UniSA-Motorsport-Test1/2024-power-and-monitoring-board/power_and_monotoring/Power_and_montoteringPDF/power_and_monotoring-logic.pdf

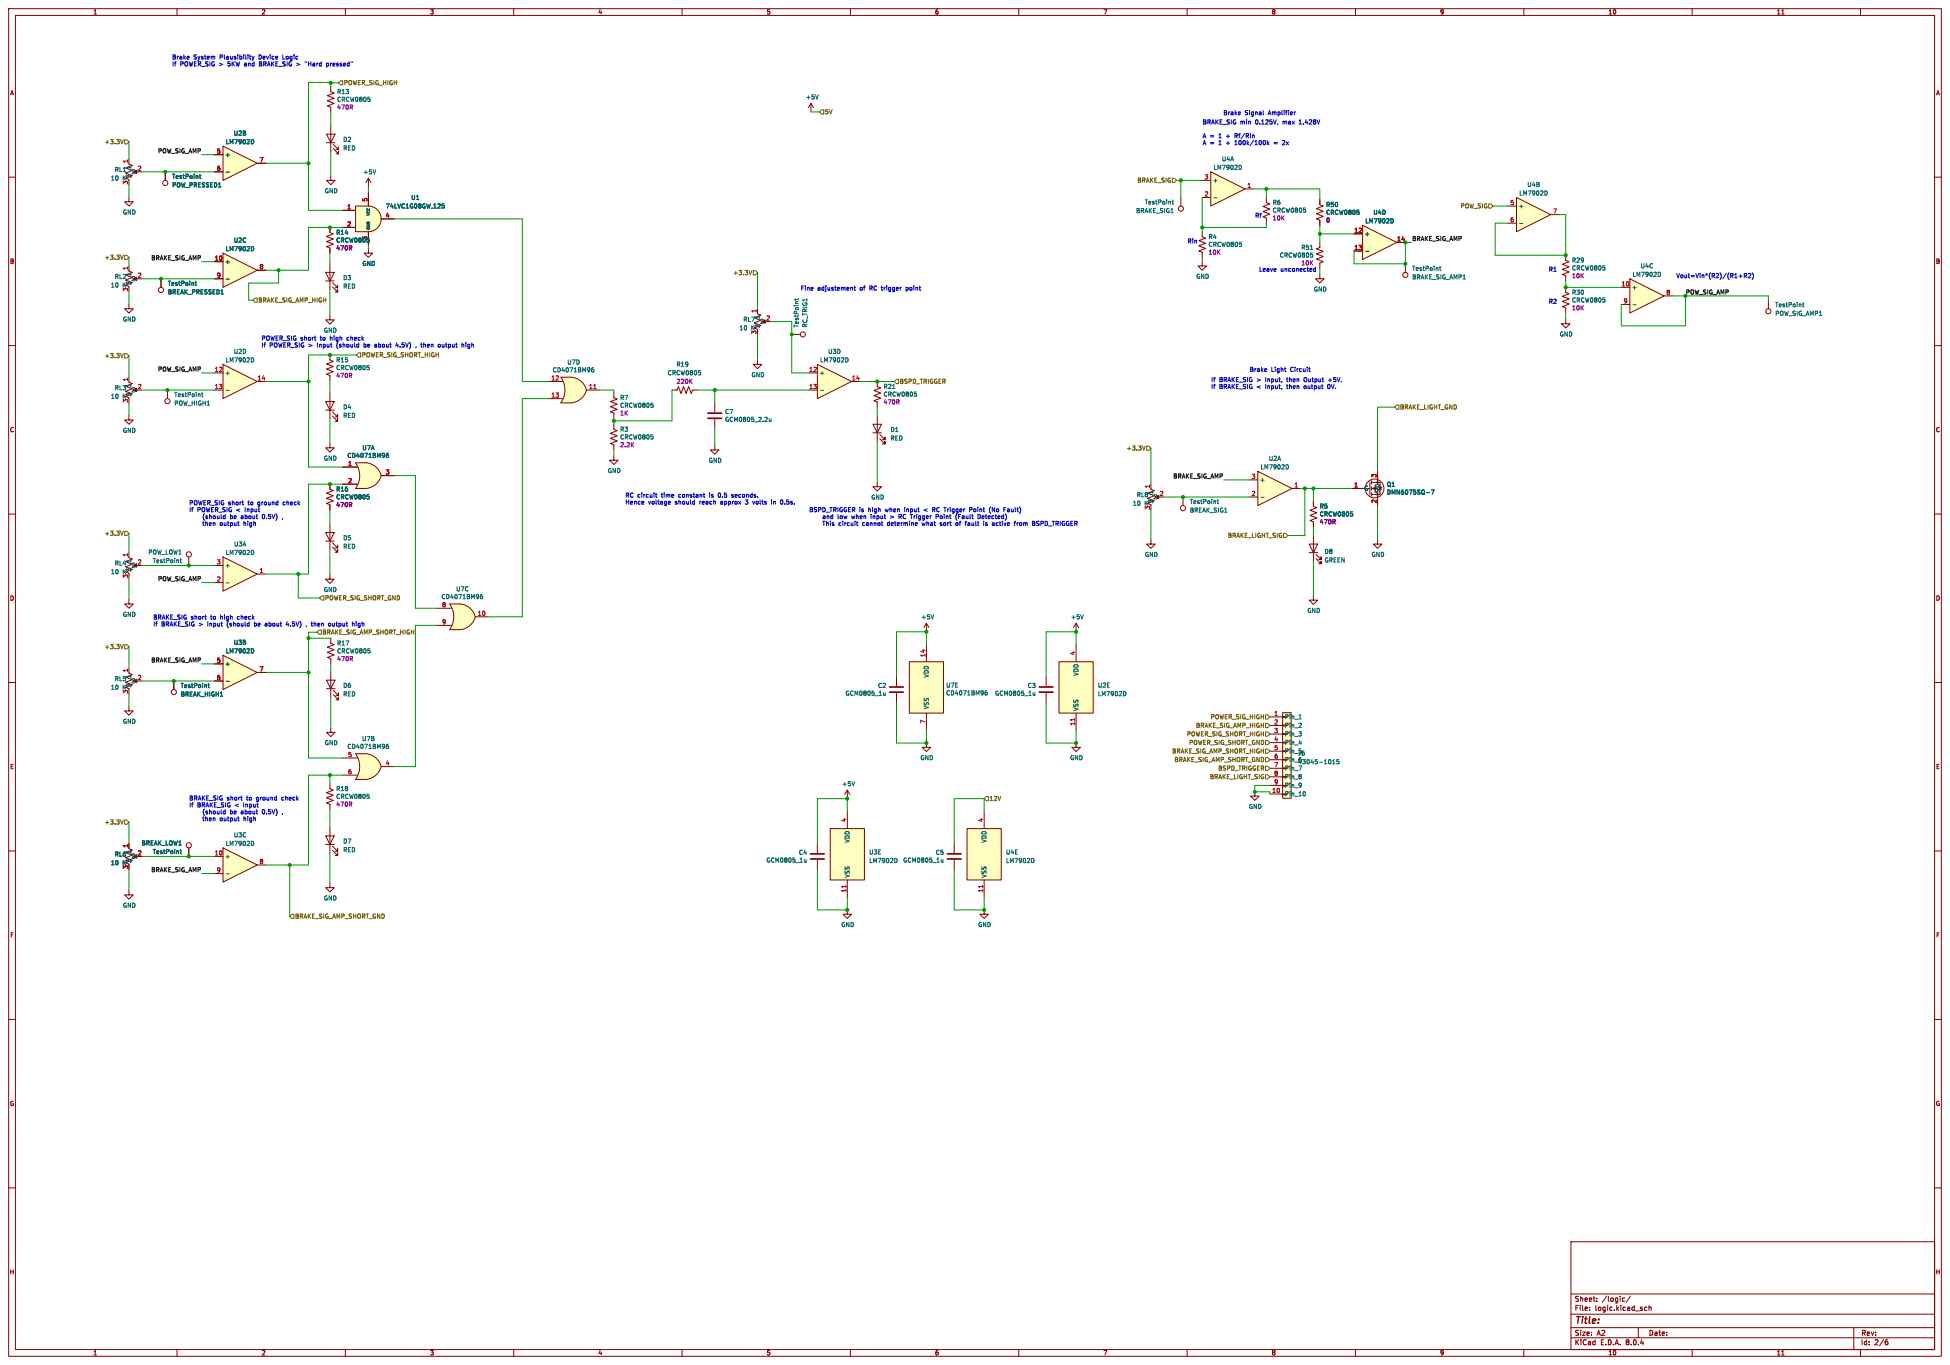
[picture p1: page 1]

If BRAKE_SIG < Input, then output 0V. Leave unconected Brake Light Circuit Brake Signal Amplifier BRAKE_SIG min 0.125V, max 1.428V

POWER_SIG short to high check

If BRAKE_SIG > Input, then Output +5V.

BRAKE_SIG short to ground check
If BRAKE_SIG < Input
then output high
