UniSA-Motorsport-Test1/2024-power-and-monitoring-board/power_and_monotoring/Power_and_montoteringPDF/power_and_monotoring.pdf

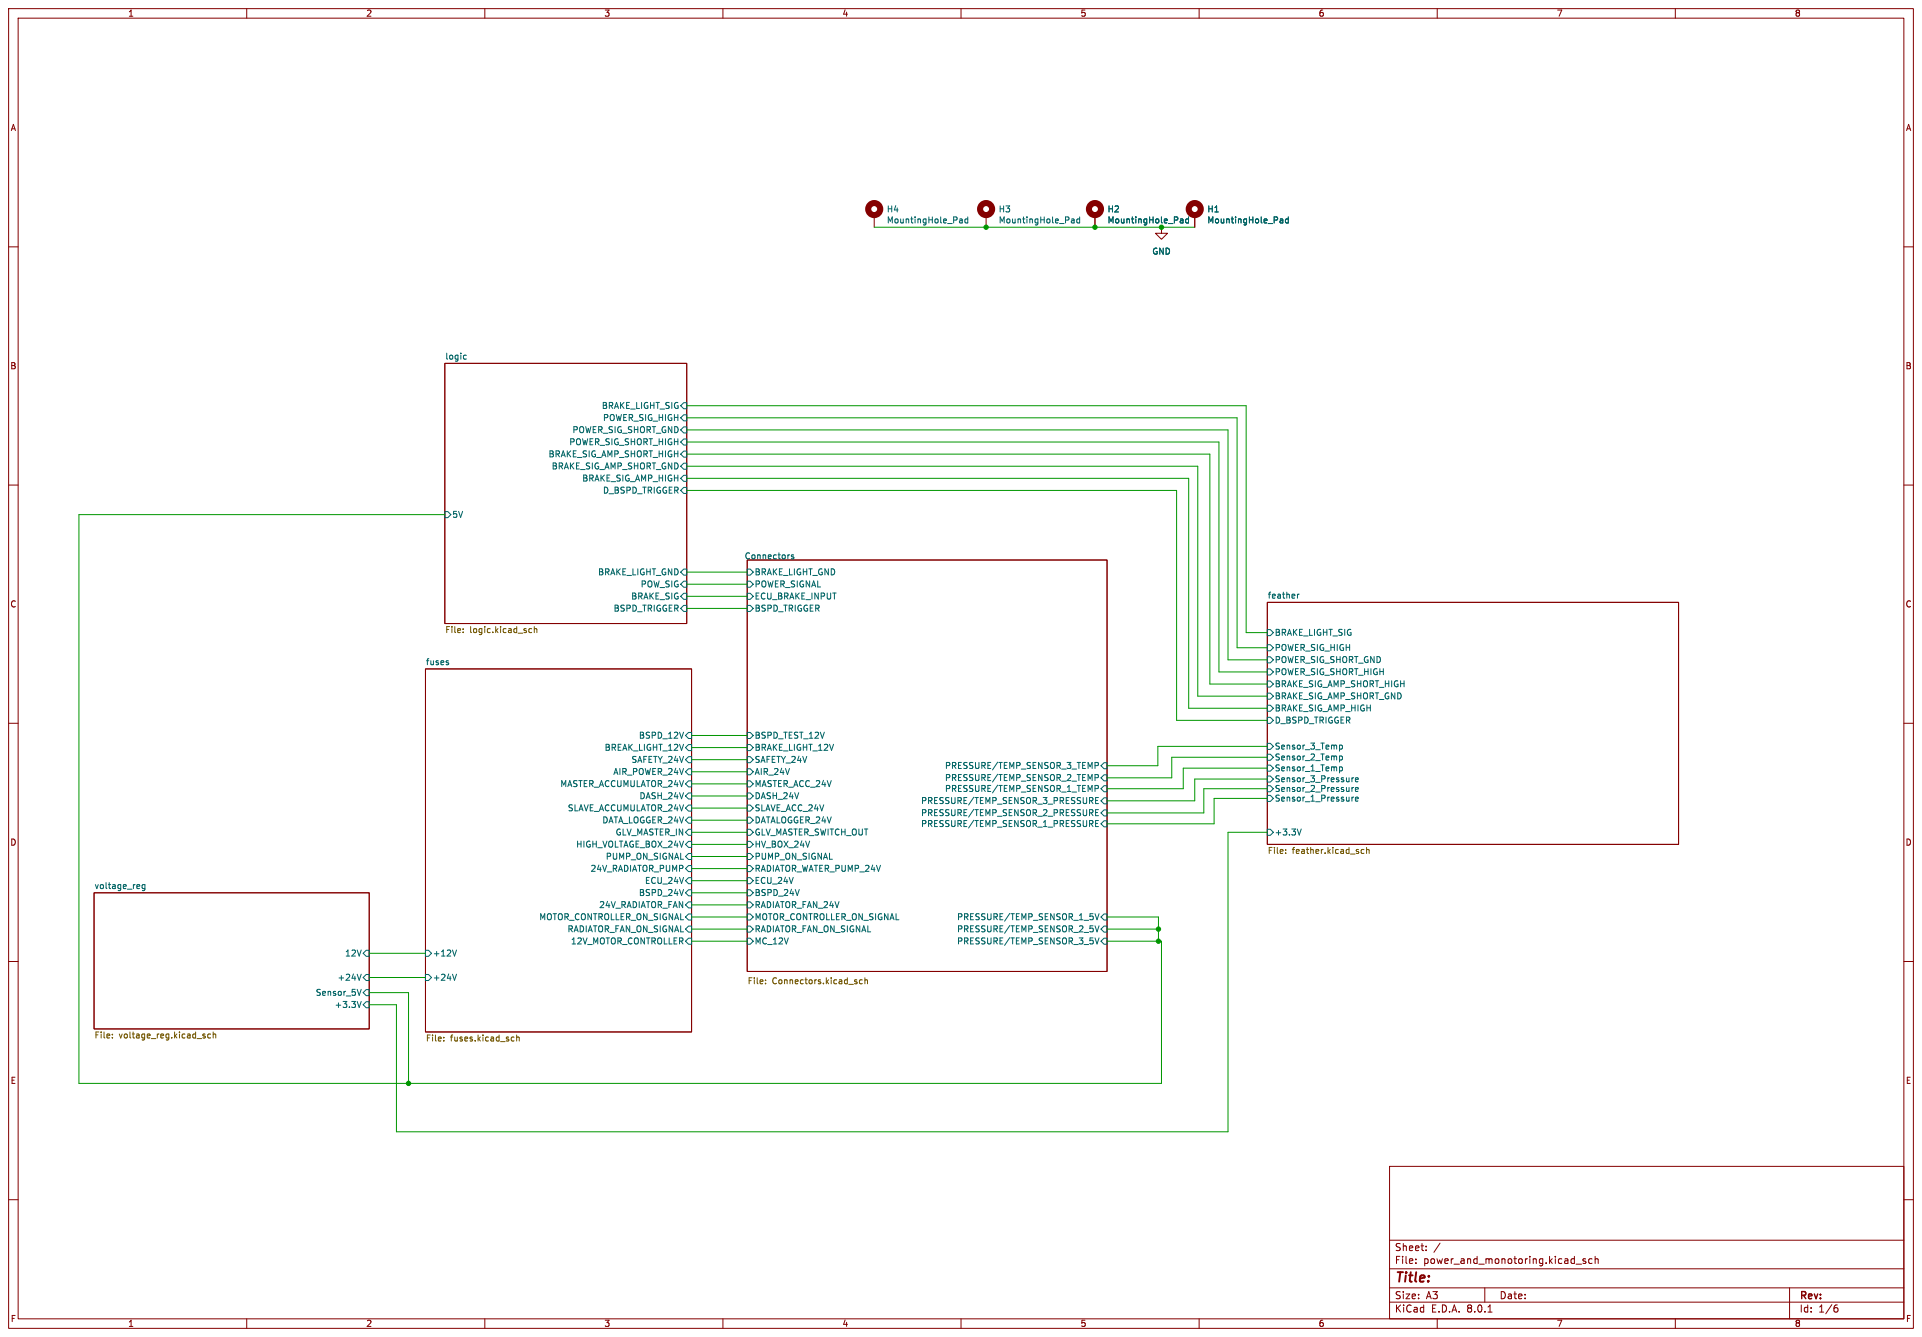
[picture p2: page 1]

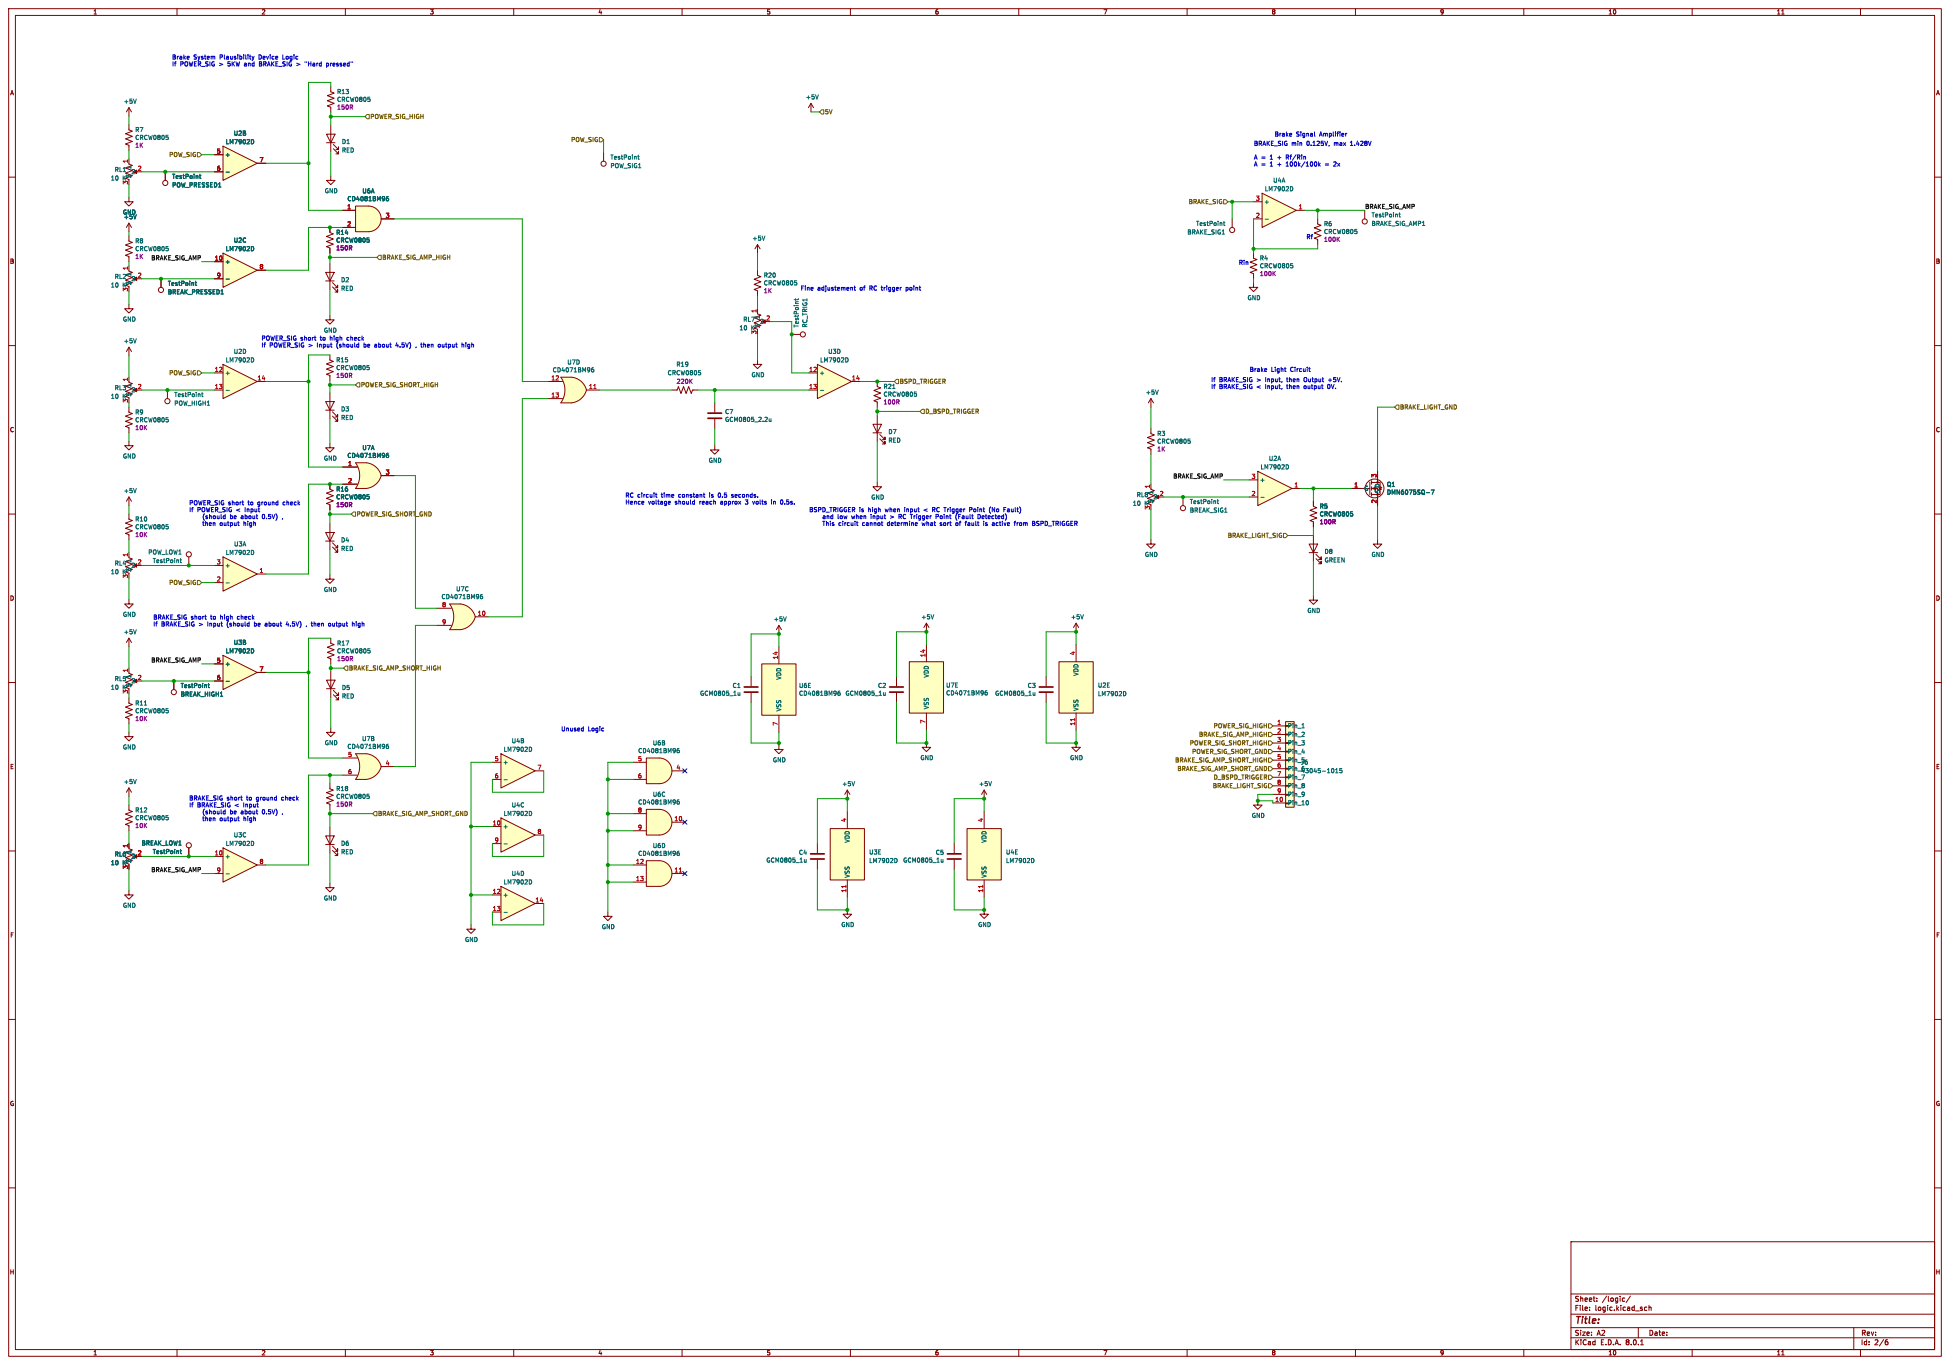
[picture p3: page 2]

If POWER_SIG > 5KW and BRAKE_SIG > "Hard pressed" POWER_SIG short to high check

If BRAKE_SIG > Input, then Output +5V.

10K GND
then output high BRAKE_SIG short to ground check

BRAKE_SIG_AMP Unused Logic BRAKE_SIG short to high check

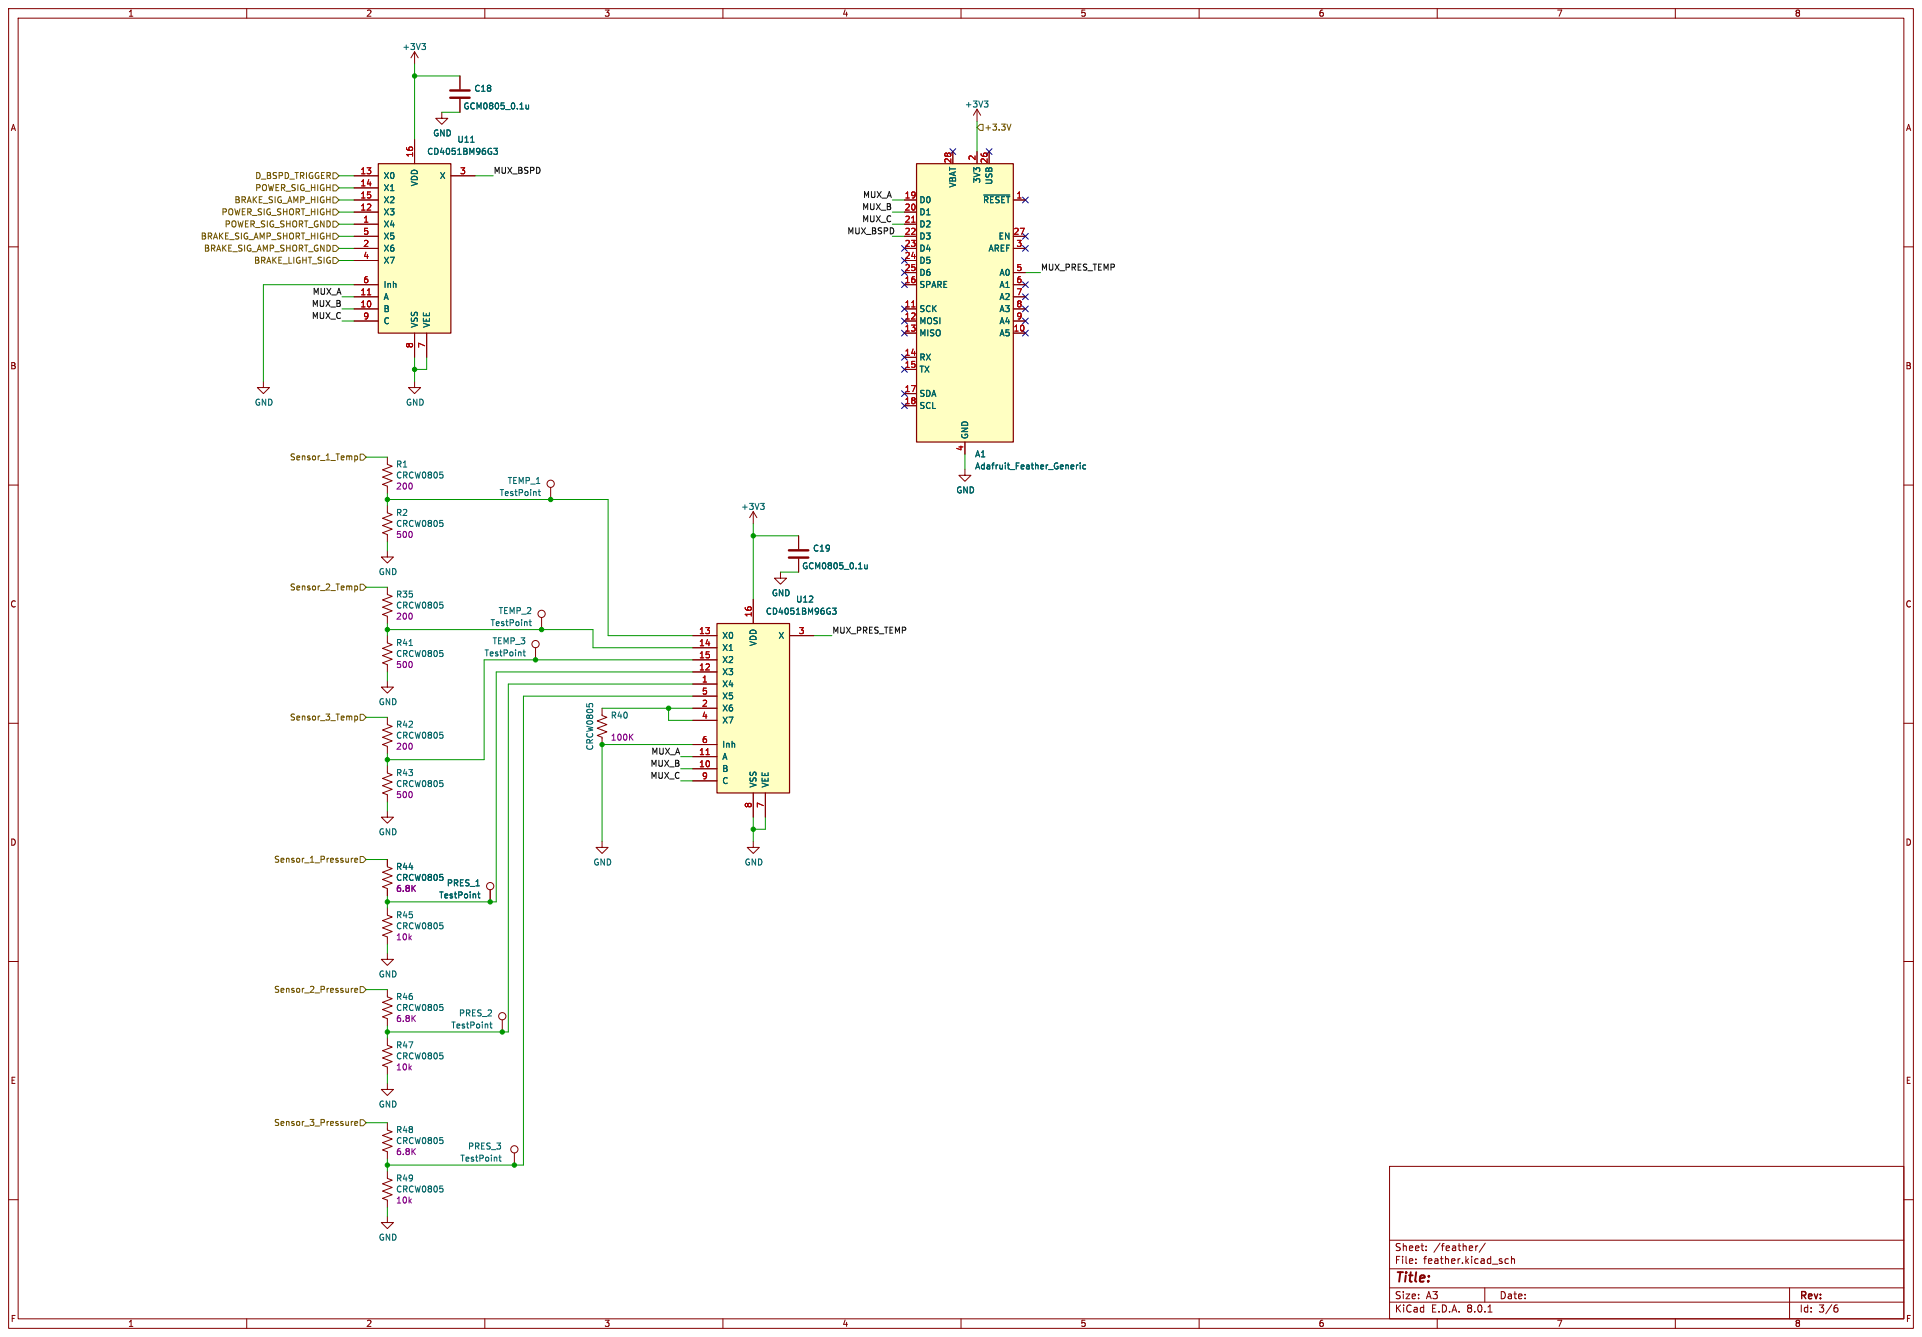
[picture p4: page 3]

Id: 3/6 Title: File: feather.kicad_sch Sheet: /feather/

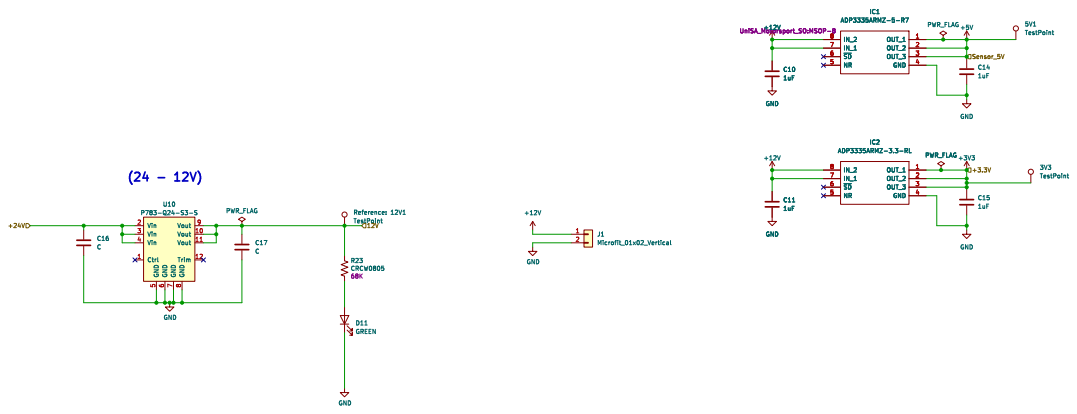
[picture p5: page 4]

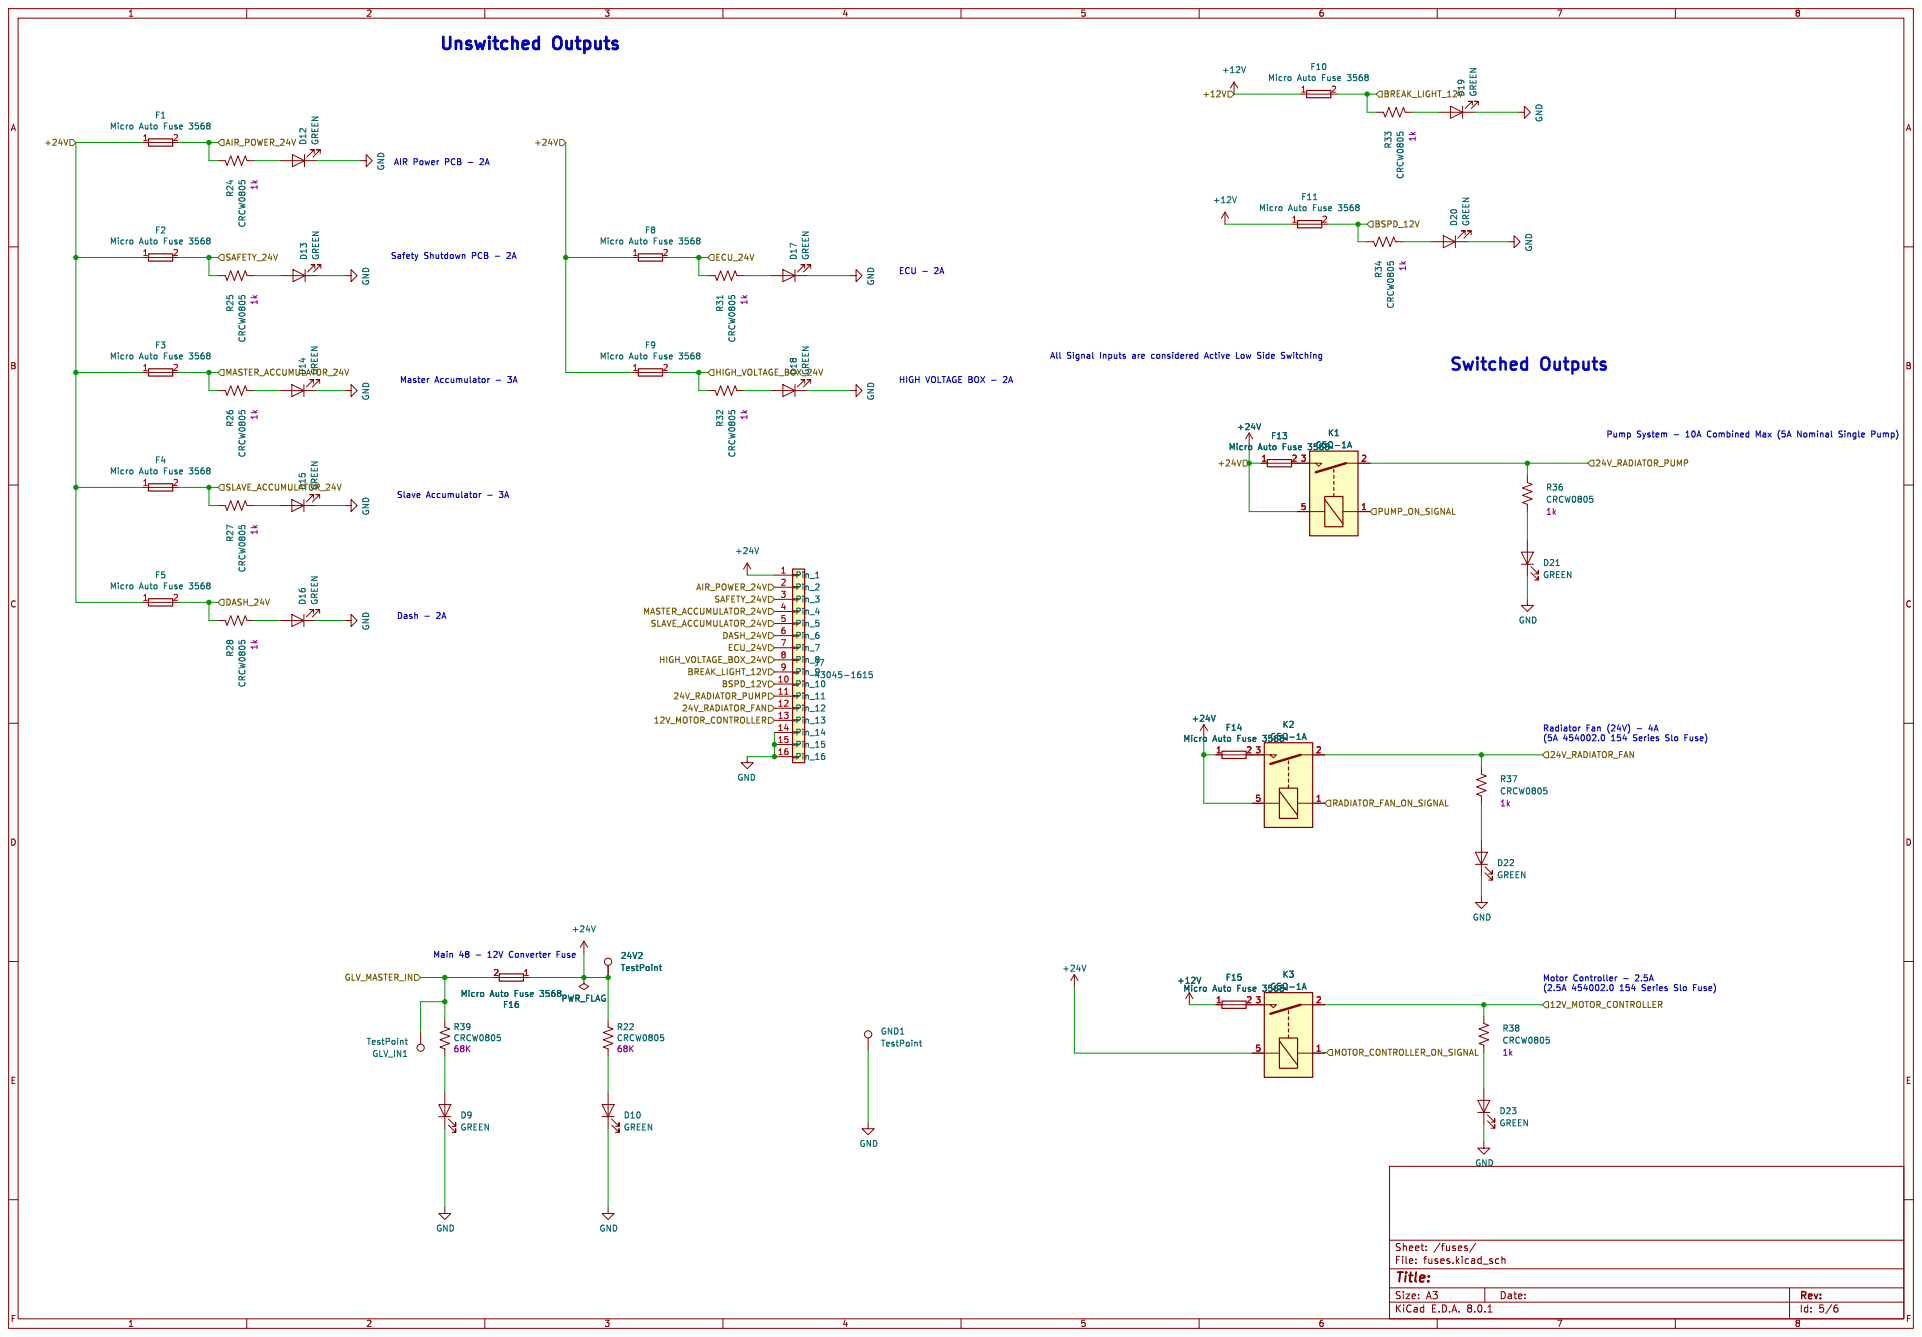
[picture p6: page 5]

AIR Power PCB - 2A Unswitched Outputs

24V2 TestPoint F16 Micro Auto Fuse 3568

Id: 5/6 Title: File: fuses.kicad_sch Sheet: /fuses/

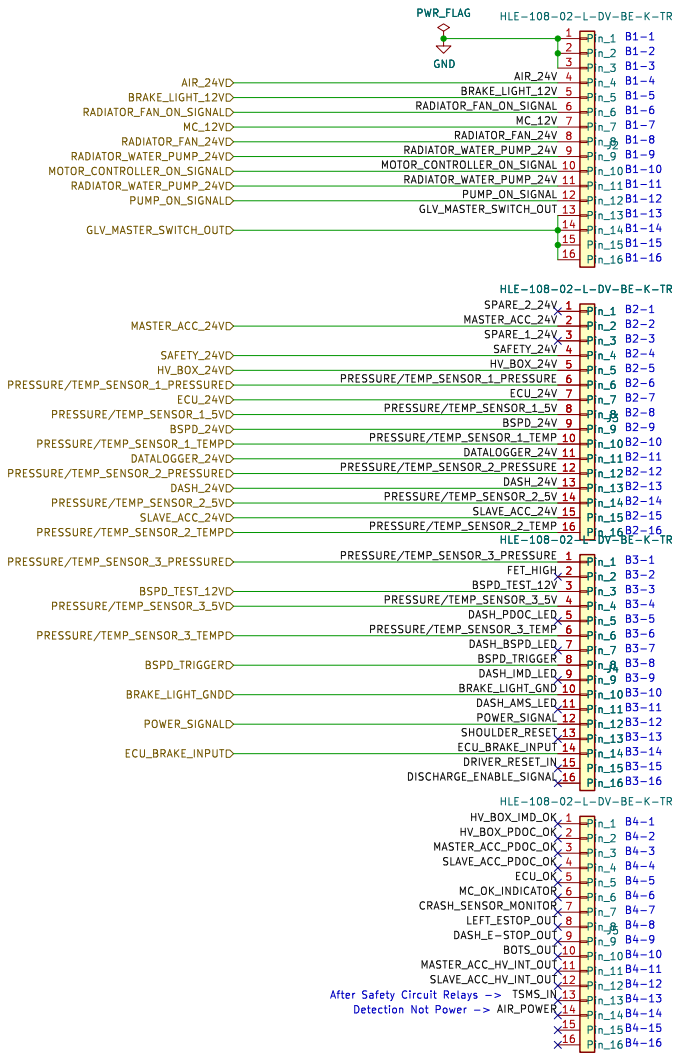
[picture p7: page 6]

PWR_FLAG
J2 HLE-108-02-L-DV-BE-K-TR GND

J3 HLE-108-02-L-DV-BE-K-TR
SPARE_2_24V

J4 HLE-108-02-L-DV-BE-K-TR

Id: 6/6 Title: File: Connectors.kicad_sch Sheet: /Connectors/
