UniSA-Motorsport-Test1/2024-power-and-monitoring-board/power_and_monotoring/power_and_monotoring.kicad_pcb

## KiCad design power_and_monotoring/power_and_monotoring.kicad_pcb (2024-10-16)

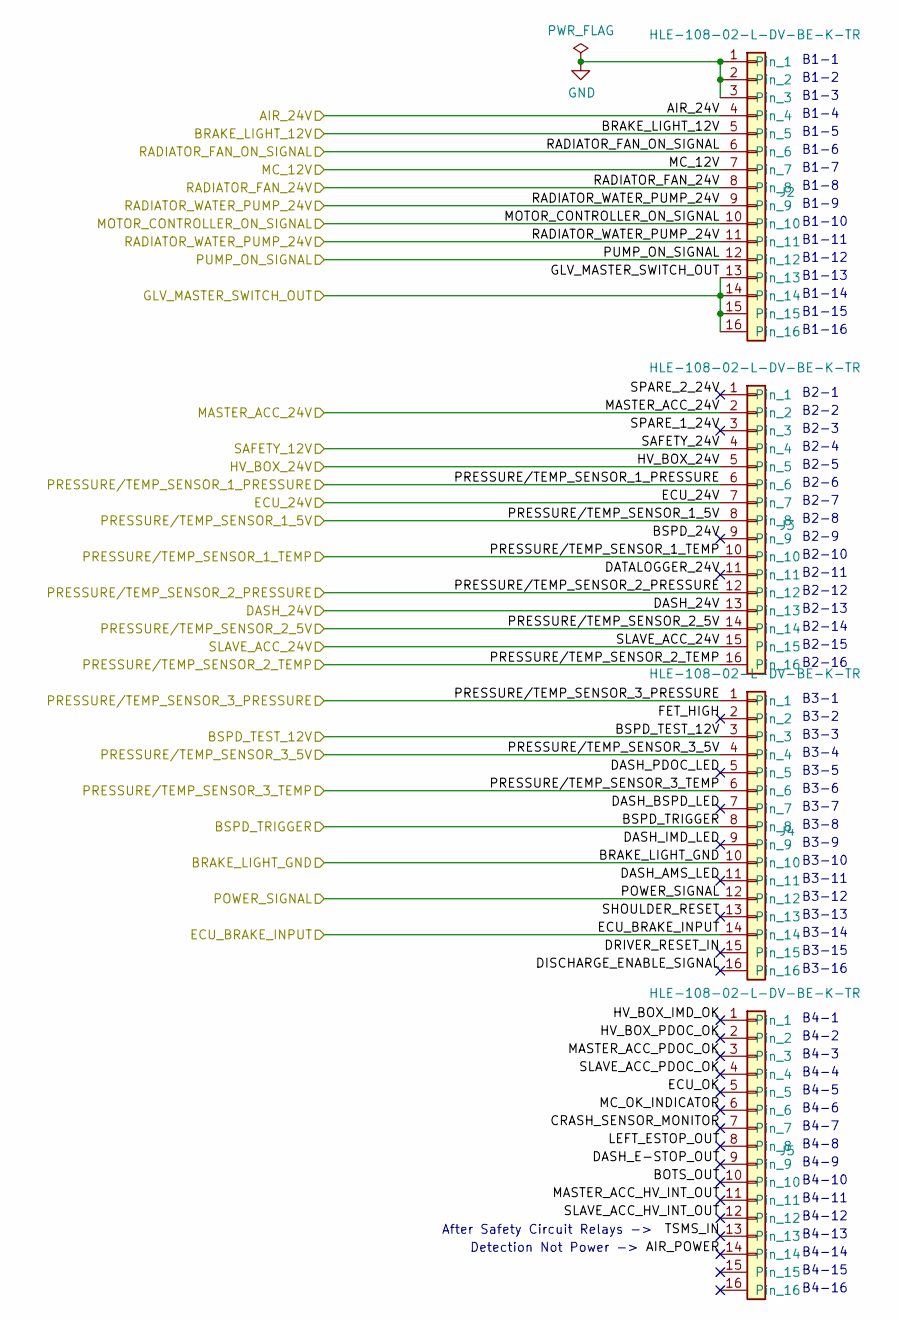
[picture p8: schematic Connectors.kicad_sch]

Parts:
J2, J3, J4, J5: HLE-108-02-L-DV-BE-K-TR; SAMTEC_HLE-108-02-L-DV-BE-K-TR

Connections:
+5V: J3.8, J3.14, J4.4; also elsewhere on the board
/Connectors/AIR_24V: J2.4; also elsewhere on the board
/Connectors/AIR_POWER: J5.14
/Connectors/BOTS_OUT: J5.10
/Connectors/BRAKE_LIGHT_12V: J2.5; also elsewhere on the board
/Connectors/BRAKE_LIGHT_GND: J4.10; also elsewhere on the board
/Connectors/BSPD_24V: J3.9
/Connectors/BSPD_TEST_12V: J4.3; also elsewhere on the board
/Connectors/BSPD_TRIGGER: J4.8; also elsewhere on the board
/Connectors/CRASH_SENSOR_MONITOR: J5.7
/Connectors/DASH_24V: J3.13; also elsewhere on the board
/Connectors/DASH_AMS_LED: J4.11
/Connectors/DASH_BSPD_LED: J4.7
/Connectors/DASH_E-STOP_OUT: J5.9
/Connectors/DASH_IMD_LED: J4.9
/Connectors/DASH_PDOC_LED: J4.5
/Connectors/DATALOGGER_24V: J3.11
/Connectors/DISCHARGE_ENABLE_SIGNAL: J4.16
/Connectors/DRIVER_RESET_IN: J4.15
/Connectors/ECU_24V: J3.7; also elsewhere on the board
/Connectors/ECU_BRAKE_INPUT: J4.14; also elsewhere on the board
/Connectors/ECU_OK: J5.5
/Connectors/FET_HIGH: J4.2
/Connectors/GLV_MASTER_SWITCH_OUT: J2.13, J2.14, J2.15, J2.16; also elsewhere on the board
/Connectors/HV_BOX_24V: J3.5; also elsewhere on the board
/Connectors/HV_BOX_IMD_OK: J5.1
/Connectors/HV_BOX_PDOC_OK: J5.2
/Connectors/LEFT_ESTOP_OUT: J5.8
/Connectors/MASTER_ACC_24V: J3.2; also elsewhere on the board
/Connectors/MASTER_ACC_HV_INT_OUT: J5.11
/Connectors/MASTER_ACC_PDOC_OK: J5.3
/Connectors/MC_12V: J2.7; also elsewhere on the board
/Connectors/MC_OK_INDICATOR: J5.6
/Connectors/MOTOR_CONTROLLER_ON_SIGNAL: J2.10; also elsewhere on the board
/Connectors/POWER_SIGNAL: J4.12; also elsewhere on the board
/Connectors/PRESSURE/TEMP_SENSOR_1_PRESSURE: J3.6; also elsewhere on the board
/Connectors/PRESSURE/TEMP_SENSOR_1_TEMP: J3.10; also elsewhere on the board
/Connectors/PRESSURE/TEMP_SENSOR_2_PRESSURE: J3.12; also elsewhere on the board
/Connectors/PRESSURE/TEMP_SENSOR_2_TEMP: J3.16; also elsewhere on the board
/Connectors/PRESSURE/TEMP_SENSOR_3_PRESSURE: J4.1; also elsewhere on the board
/Connectors/PRESSURE/TEMP_SENSOR_3_TEMP: J4.6; also elsewhere on the board
/Connectors/PUMP_ON_SIGNAL: J2.12; also elsewhere on the board
/Connectors/RADIATOR_FAN_24V: J2.8; also elsewhere on the board
/Connectors/RADIATOR_FAN_ON_SIGNAL: J2.6; also elsewhere on the board
/Connectors/RADIATOR_WATER_PUMP_24V: J2.9, J2.11; also elsewhere on the board
/Connectors/SAFETY_24V: J3.4; also elsewhere on the board
/Connectors/SHOULDER_RESET: J4.13
/Connectors/SLAVE_ACC_24V: J3.15; also elsewhere on the board
/Connectors/SLAVE_ACC_HV_INT_OUT: J5.12
/Connectors/SLAVE_ACC_PDOC_OK: J5.4
/Connectors/SPARE_1_24V: J3.3
/Connectors/SPARE_2_24V: J3.1
/Connectors/TSMS_IN: J5.13
GND: J2.1, J2.2, J2.3; also elsewhere on the board

Notes on the sheet:
B4-14
B3-5
B2-14
B2-9
B2-2
B3-8
B3-9
B3-11
B3-15
B2-15
B2-4
B4-3
B3-4
B2-16
B4-7
After Safety Circuit Relays ->
B1-9
B2-8
B4-5
B1-4
B1-2
B4-9
Detection Not Power ->
B3-12
B1-12
B2-6
B1-6
B4-10
B1-14
B1-8
B3-2
B4-1
B3-10
B3-1
B2-13
B1-7
B4-2
B2-3
B4-12
B3-13
B1-10
B2-10
B2-11
B2-12
B1-16
B1-11
B3-7
B1-5
B3-16
B4-4
B3-14
B2-1
B4-16
B1-3
B3-3
B2-5
B4-11
B3-6
B4-13
B1-15
B1-13
B1-1
B4-15
B4-8
B4-6
B2-7

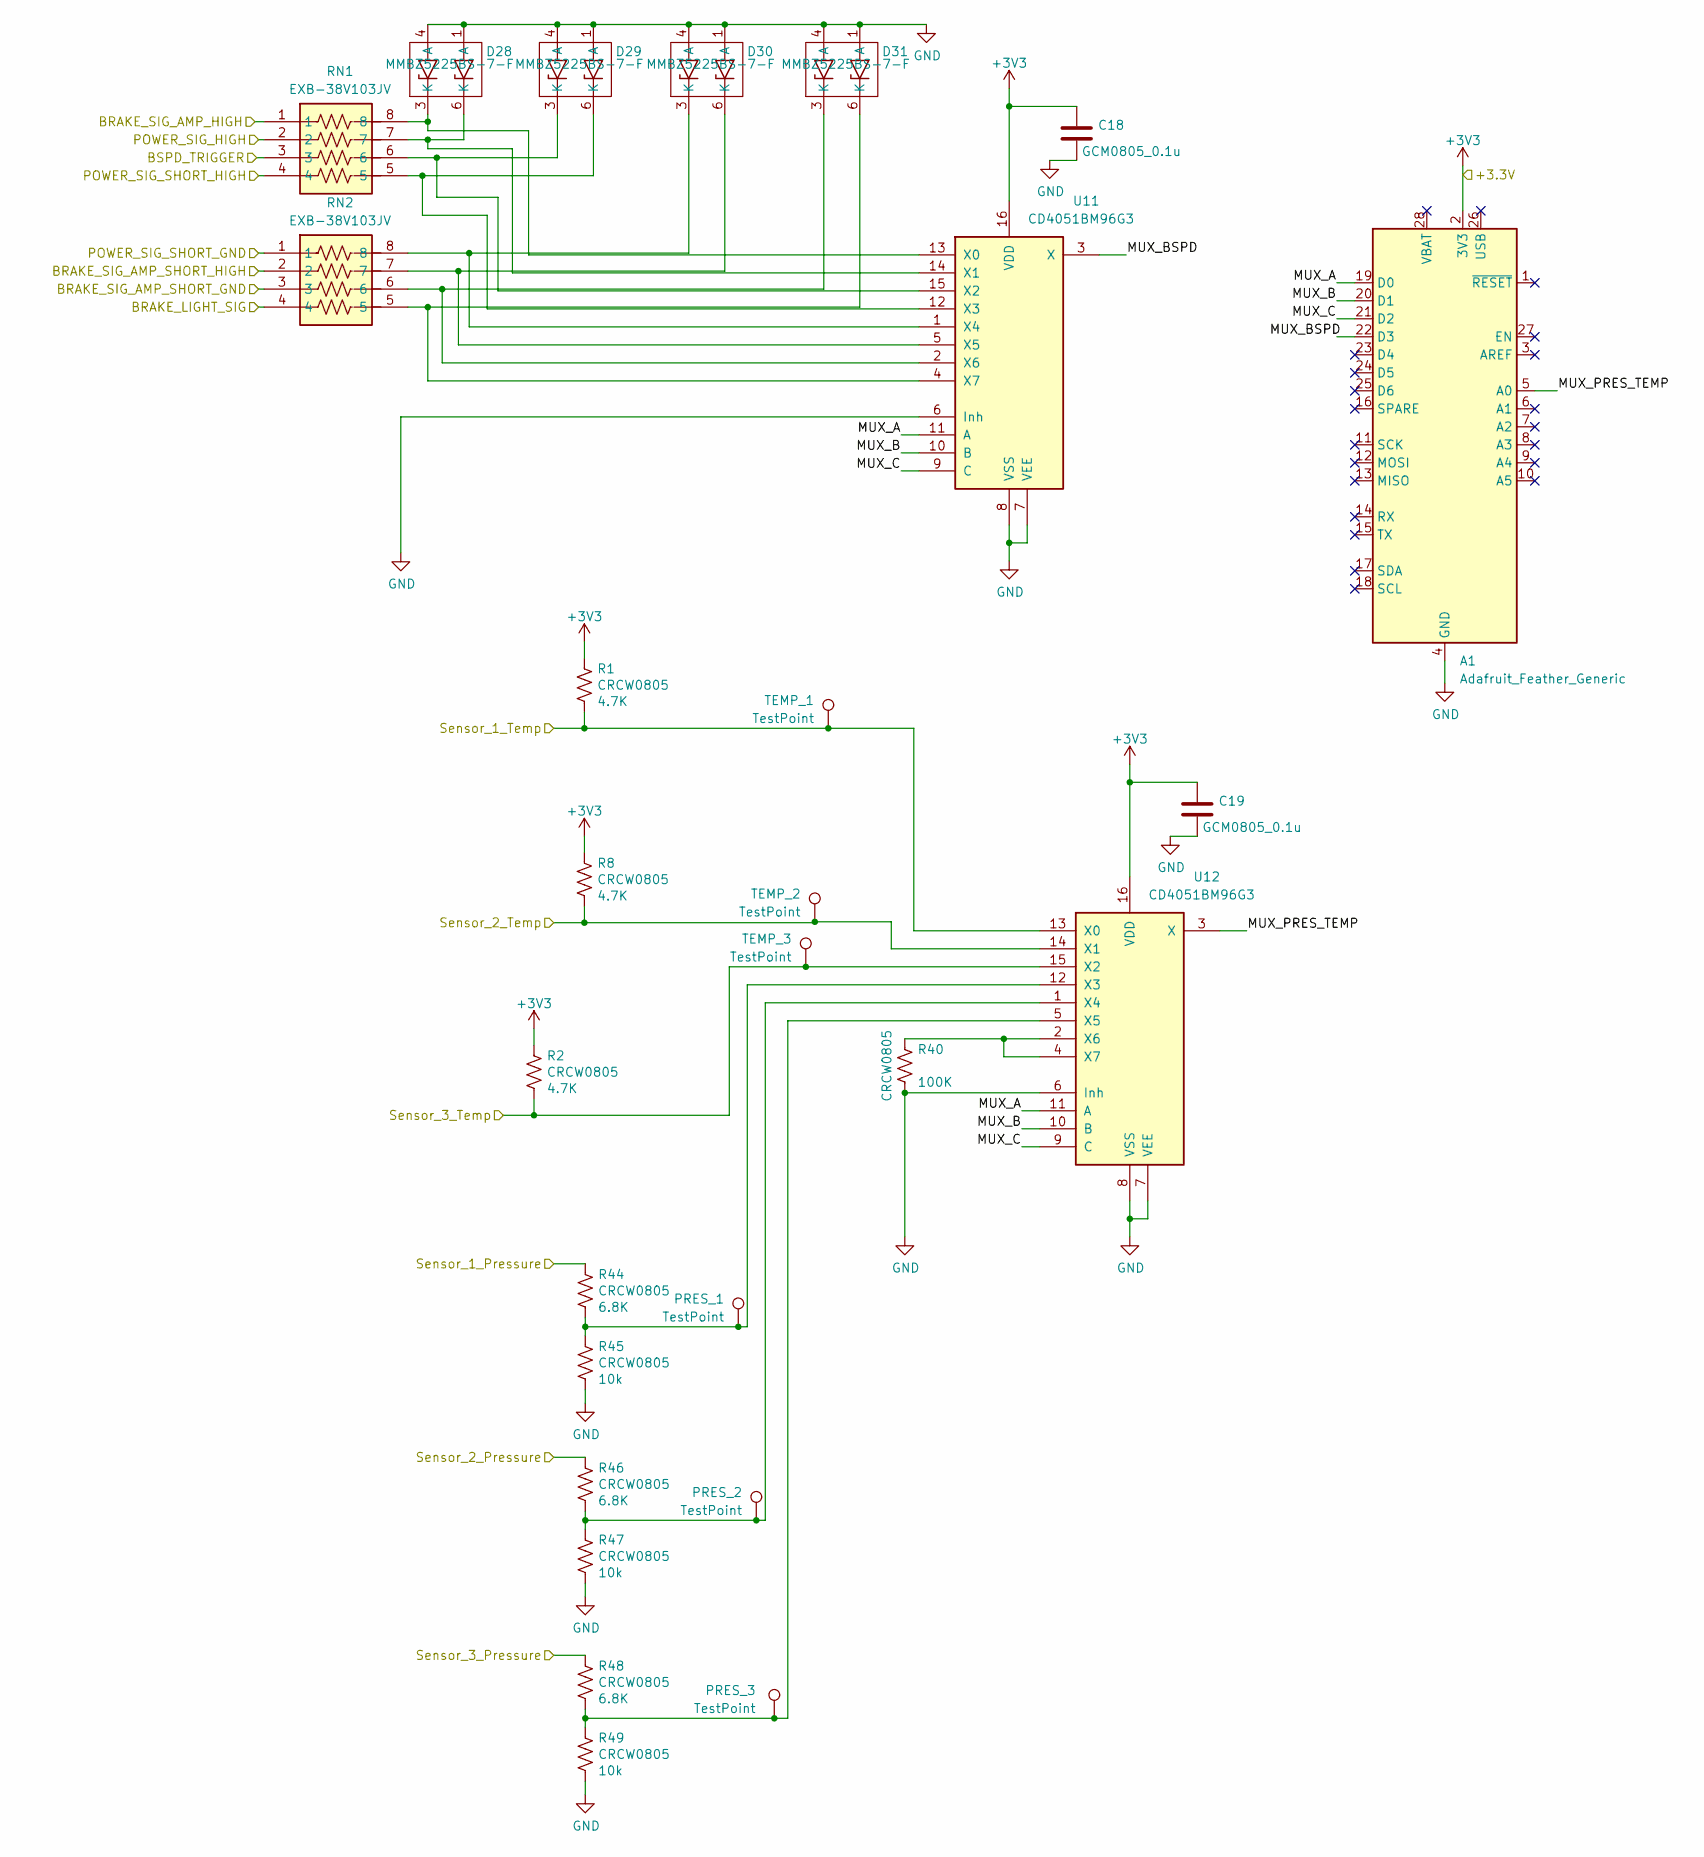
[picture p9: schematic feather.kicad_sch]

Parts:
A1: Adafruit_Feather_Generic; Adafruit_Feather_WithMountingHoles
C18, C19: GCM0805_0.1u; 0805; Voltage Rating 16V
D28, D29, D30, D31: MMBZ5225BS-7-F; SOT-363
PRES_1, PRES_2, PRES_3: TestPoint; TestPoint_Pad_D2.0mm
R1, R2, R8, R40, R44, R45, R46, R47, R48, R49: CRCW0805; 0805; Voltage Rating 150V; Power Rating 125mW
RN1, RN2: EXB-38V103JV; EXB38V472JV; Mouser Part Number 667-EXB-38V103JV
TEMP_1, TEMP_2, TEMP_3: TestPoint; TestPoint_Pad_D2.0mm
U11, U12: CD4051BM96G3; SOIC-16

Connections:
+3V3: A1.2 (3V3), C18.1, C19.1, R1.1, R2.1, R8.1, U11.16 (VDD), U12.16 (VDD); also elsewhere on the board
/Connectors/BSPD_TRIGGER: RN1.3; also elsewhere on the board
/Connectors/PRESSURE/TEMP_SENSOR_1_PRESSURE: R44.1; also elsewhere on the board
/Connectors/PRESSURE/TEMP_SENSOR_1_TEMP: R1.2, TEMP_1.1, U12.13 (X0); also elsewhere on the board
/Connectors/PRESSURE/TEMP_SENSOR_2_PRESSURE: R46.1; also elsewhere on the board
/Connectors/PRESSURE/TEMP_SENSOR_2_TEMP: R8.2, TEMP_2.1, U12.14 (X1); also elsewhere on the board
/Connectors/PRESSURE/TEMP_SENSOR_3_PRESSURE: R48.1; also elsewhere on the board
/Connectors/PRESSURE/TEMP_SENSOR_3_TEMP: R2.2, TEMP_3.1, U12.15 (X2); also elsewhere on the board
/feather/BRAKE_LIGHT_SIG: RN2.4; also elsewhere on the board
/feather/BRAKE_SIG_AMP_HIGH: RN1.1; also elsewhere on the board
/feather/BRAKE_SIG_AMP_SHORT_GND: RN2.3; also elsewhere on the board
/feather/BRAKE_SIG_AMP_SHORT_HIGH: RN2.2; also elsewhere on the board
/feather/MUX_A: A1.19 (D0), U11.11 (A), U12.11 (A)
/feather/MUX_B: A1.20 (D1), U11.10 (B), U12.10 (B)
/feather/MUX_BSPD: A1.22 (D3), U11.3 (X)
/feather/MUX_C: A1.21 (D2), U11.9 (C), U12.9 (C)
/feather/MUX_PRES_TEMP: A1.5 (A0), U12.3 (X)
/feather/POWER_SIG_HIGH: RN1.2; also elsewhere on the board
/feather/POWER_SIG_SHORT_GND: RN2.1; also elsewhere on the board
/feather/POWER_SIG_SHORT_HIGH: RN1.4; also elsewhere on the board
GND: A1.4 (GND), C18.2, C19.2, D28.1 (A), D28.4 (A), D29.1 (A), D29.4 (A), D30.1 (A), D30.4 (A), D31.1 (A), D31.4 (A), R40.2, R45.2, R47.2, R49.2, U11.6 (Inh), U11.7 (VEE), U11.8 (VSS), U12.6 (Inh), U12.7 (VEE), U12.8 (VSS); also elsewhere on the board
unnamed: D28.3 (K), RN1.8, U11.13 (X0)
unnamed: D28.6 (K), RN1.7, U11.14 (X1)
unnamed: D29.3 (K), RN1.6, U11.15 (X2)
unnamed: D29.6 (K), RN1.5, U11.12 (X3)
unnamed: D30.3 (K), RN2.8, U11.1 (X4)
unnamed: D30.6 (K), RN2.7, U11.5 (X5)
unnamed: D31.3 (K), RN2.6, U11.2 (X6)
unnamed: D31.6 (K), RN2.5, U11.4 (X7)
unnamed: PRES_1.1, R44.2, R45.1, U12.12 (X3)
unnamed: PRES_2.1, R46.2, R47.1, U12.1 (X4)
unnamed: PRES_3.1, R48.2, R49.1, U12.5 (X5)
unnamed: R40.1, U12.2 (X6), U12.4 (X7)

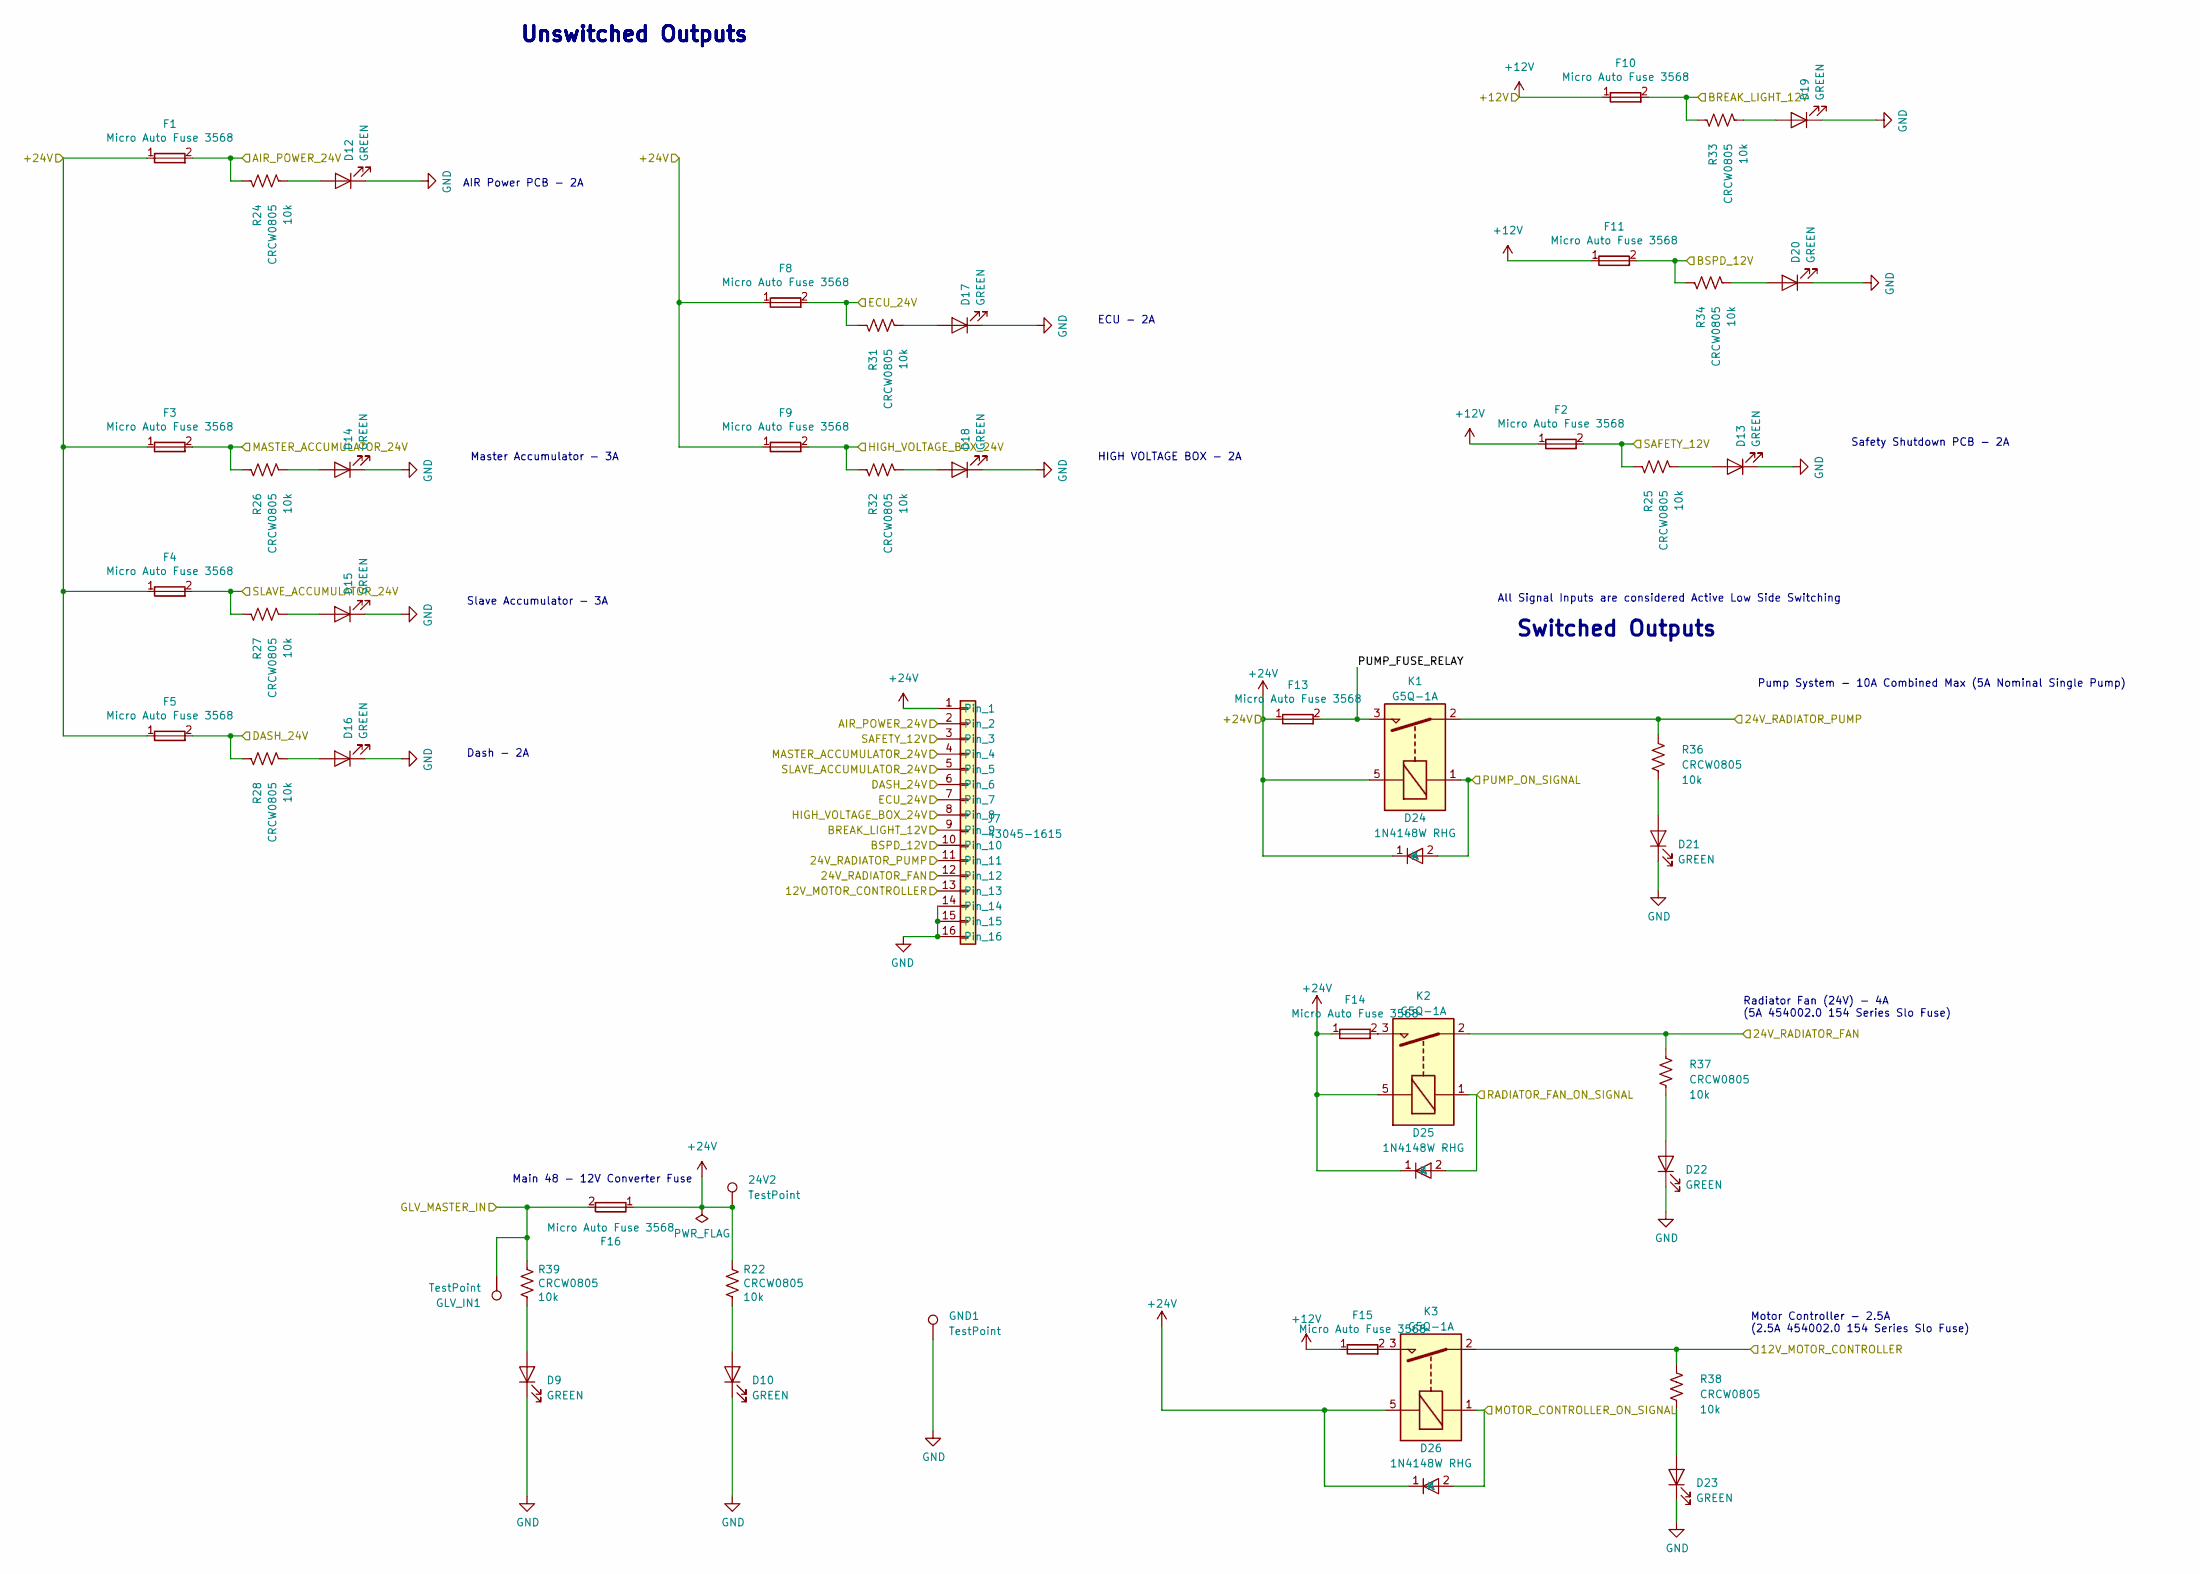
[picture p10: schematic fuses.kicad_sch]

Parts:
24V2: TestPoint; TestPoint_Pad_D2.0mm
D9, D10, D12, D13, D14, D15, D16, D17, D18, D19, D20, D21, D22, D23: GREEN; 0805
D24, D25, D26: 1N4148W RHG; SOD-123F-2
F1, F2, F3, F4, F5, F8, F9, F10, F11, F13, F14, F15, F16: Micro Auto Fuse 3568; Fuseholder_Blade_Mini_Keystone_3568; Voltage Rating 60V; Current Rating 10A
GLV_IN1: TestPoint; TestPoint_Pad_D2.0mm
GND1: TestPoint; TestPoint_Pad_D2.0mm
J7: 43045-1615; MOLEX_43045-16YY_16PIN
K1, K2, K3: G5Q-1A; Relay_SPST_Omron-G5Q-1A
R22, R24, R25, R26, R27, R28, R31, R32, R33, R34, R36, R37, R38, R39: CRCW0805; 0805; Voltage Rating 50V; Power Rating 63mW

Connections:
+12V: F2.1, F10.1, F11.1, F15.1; also elsewhere on the board
+24V: 24V2.1, D24.1 (K), D25.1 (K), D26.1 (K), F1.1, F3.1, F4.1, F5.1, F8.1, F9.1, F13.1, F14.1, F16.1, J7.1, K1.5, K2.5, K3.5, R22.1; also elsewhere on the board
/Connectors/AIR_24V: F1.2, J7.2, R24.1; also elsewhere on the board
/Connectors/BRAKE_LIGHT_12V: F10.2, J7.9, R33.1; also elsewhere on the board
/Connectors/BSPD_TEST_12V: F11.2, J7.10, R34.1; also elsewhere on the board
/Connectors/DASH_24V: F5.2, J7.6, R28.1; also elsewhere on the board
/Connectors/ECU_24V: F8.2, J7.7, R31.1; also elsewhere on the board
/Connectors/GLV_MASTER_SWITCH_OUT: F16.2, GLV_IN1.1, R39.1; also elsewhere on the board
/Connectors/HV_BOX_24V: F9.2, J7.8, R32.1; also elsewhere on the board
/Connectors/MASTER_ACC_24V: F3.2, J7.4, R26.1; also elsewhere on the board
/Connectors/MC_12V: J7.13, K3.2, R38.1; also elsewhere on the board
/Connectors/MOTOR_CONTROLLER_ON_SIGNAL: D26.2 (A), K3.1; also elsewhere on the board
/Connectors/PUMP_ON_SIGNAL: D24.2 (A), K1.1; also elsewhere on the board
/Connectors/RADIATOR_FAN_24V: J7.12, K2.2, R37.1; also elsewhere on the board
/Connectors/RADIATOR_FAN_ON_SIGNAL: D25.2 (A), K2.1; also elsewhere on the board
/Connectors/RADIATOR_WATER_PUMP_24V: J7.11, K1.2, R36.1; also elsewhere on the board
/Connectors/SAFETY_24V: F2.2, J7.3, R25.1; also elsewhere on the board
/Connectors/SLAVE_ACC_24V: F4.2, J7.5, R27.1; also elsewhere on the board
/fuses/PUMP_FUSE_RELAY: F13.2, K1.3
GND: D9.1 (K), D10.1 (K), D12.1 (K), D13.1 (K), D14.1 (K), D15.1 (K), D16.1 (K), D17.1 (K), D18.1 (K), D19.1 (K), D20.1 (K), D21.1 (K), D22.1 (K), D23.1 (K), GND1.1, J7.14, J7.15, J7.16; also elsewhere on the board
unnamed: D9.2 (A), R39.2
unnamed: D10.2 (A), R22.2
unnamed: D12.2 (A), R24.2
unnamed: D13.2 (A), R25.2
unnamed: D14.2 (A), R26.2
unnamed: D15.2 (A), R27.2
unnamed: D16.2 (A), R28.2
unnamed: D17.2 (A), R31.2
unnamed: D18.2 (A), R32.2
unnamed: D19.2 (A), R33.2
unnamed: D20.2 (A), R34.2
unnamed: D21.2 (A), R36.2
unnamed: D22.2 (A), R37.2
unnamed: D23.2 (A), R38.2
unnamed: F14.2, K2.3
unnamed: F15.2, K3.3

Notes on the sheet:
ECU - 2A
Motor Controller - 2.5A (2.5A 454002.0 154 Series Slo Fuse)
Unswitched Outputs
AIR Power PCB - 2A
Safety Shutdown PCB - 2A
All Signal Inputs are considered Active Low Side Switching
HIGH VOLTAGE BOX - 2A
Radiator Fan (24V) - 4A (5A 454002.0 154 Series Slo Fuse)
Main 48 - 12V Converter Fuse
Dash - 2A
Master Accumulator - 3A
Switched Outputs
Pump System - 10A Combined Max (5A Nominal Single Pump)
Slave Accumulator - 3A

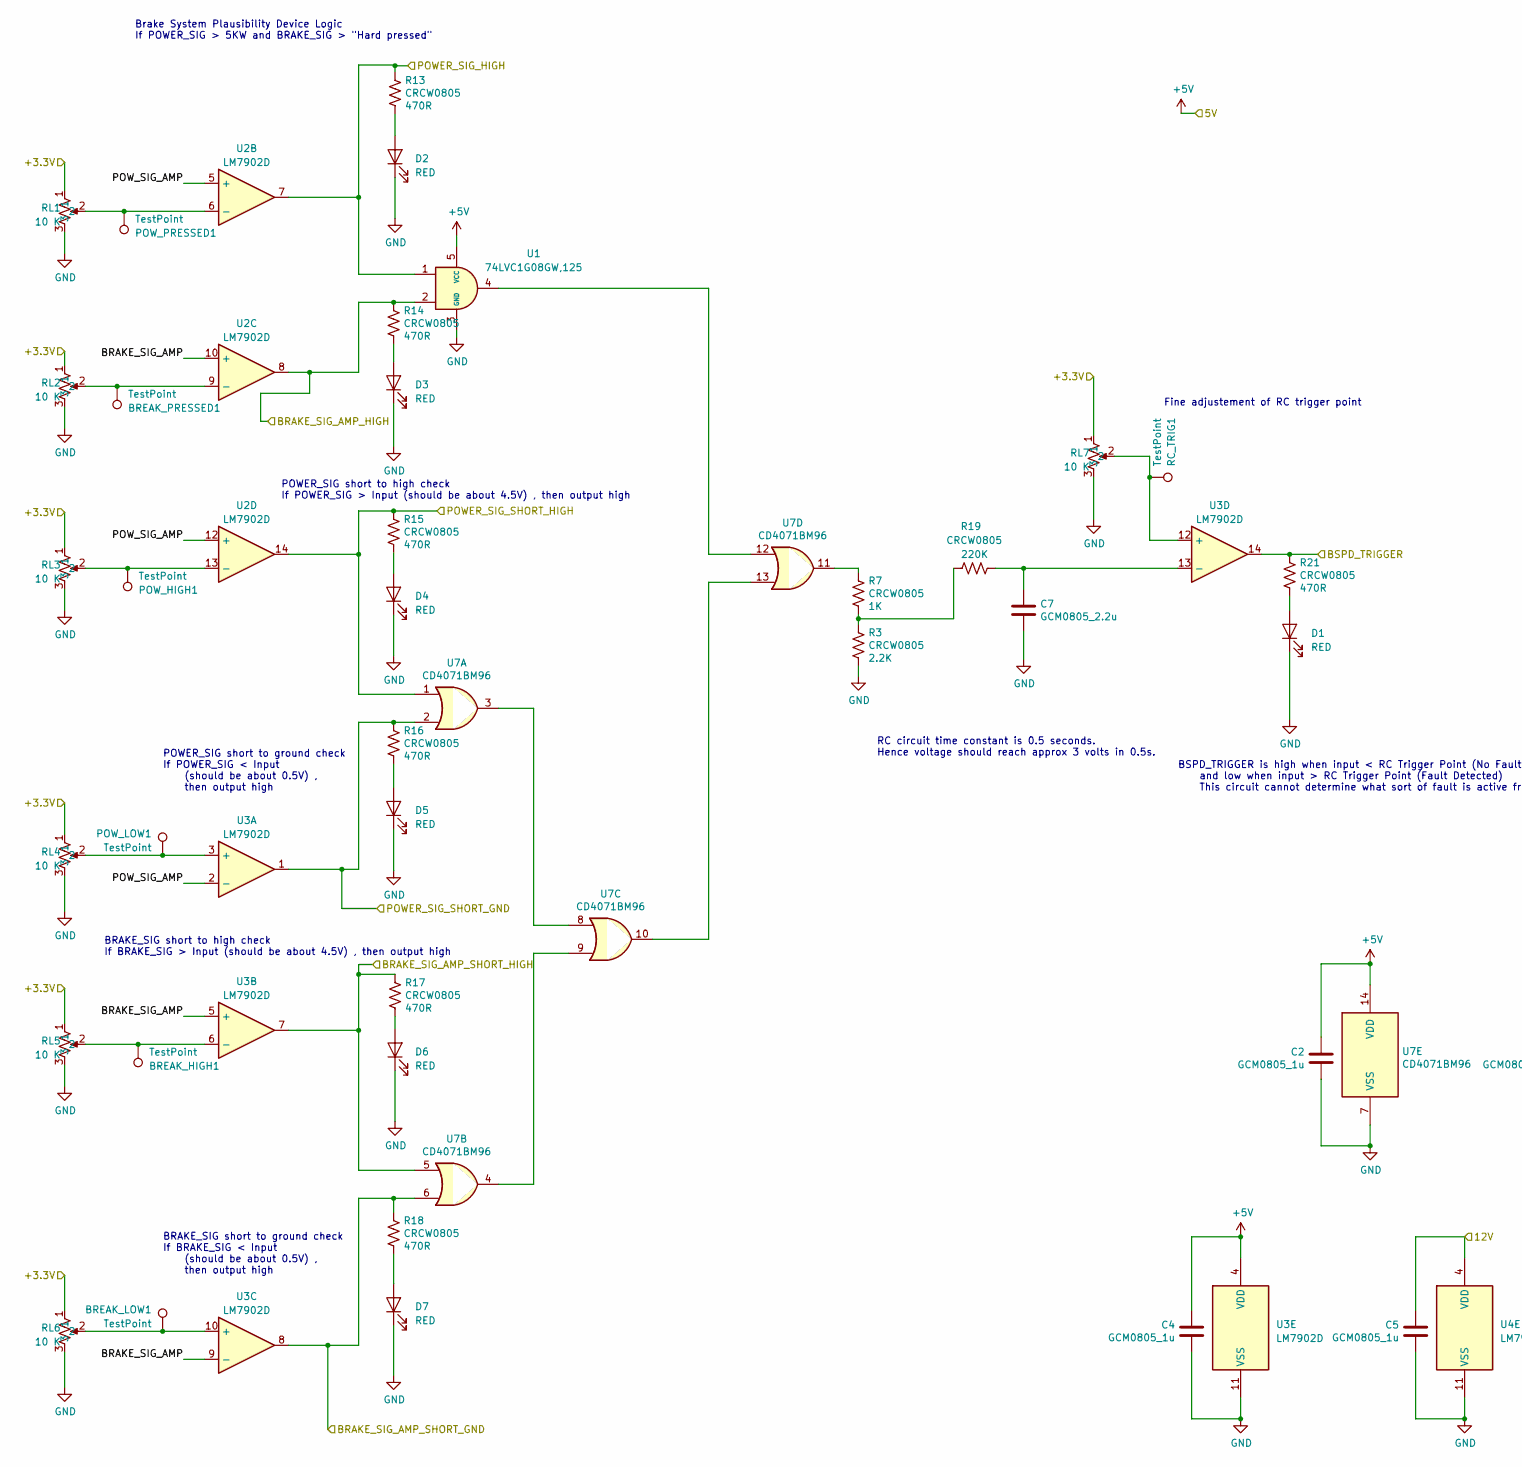
[picture p11: schematic logic.kicad_sch, part in row 1, column 1]

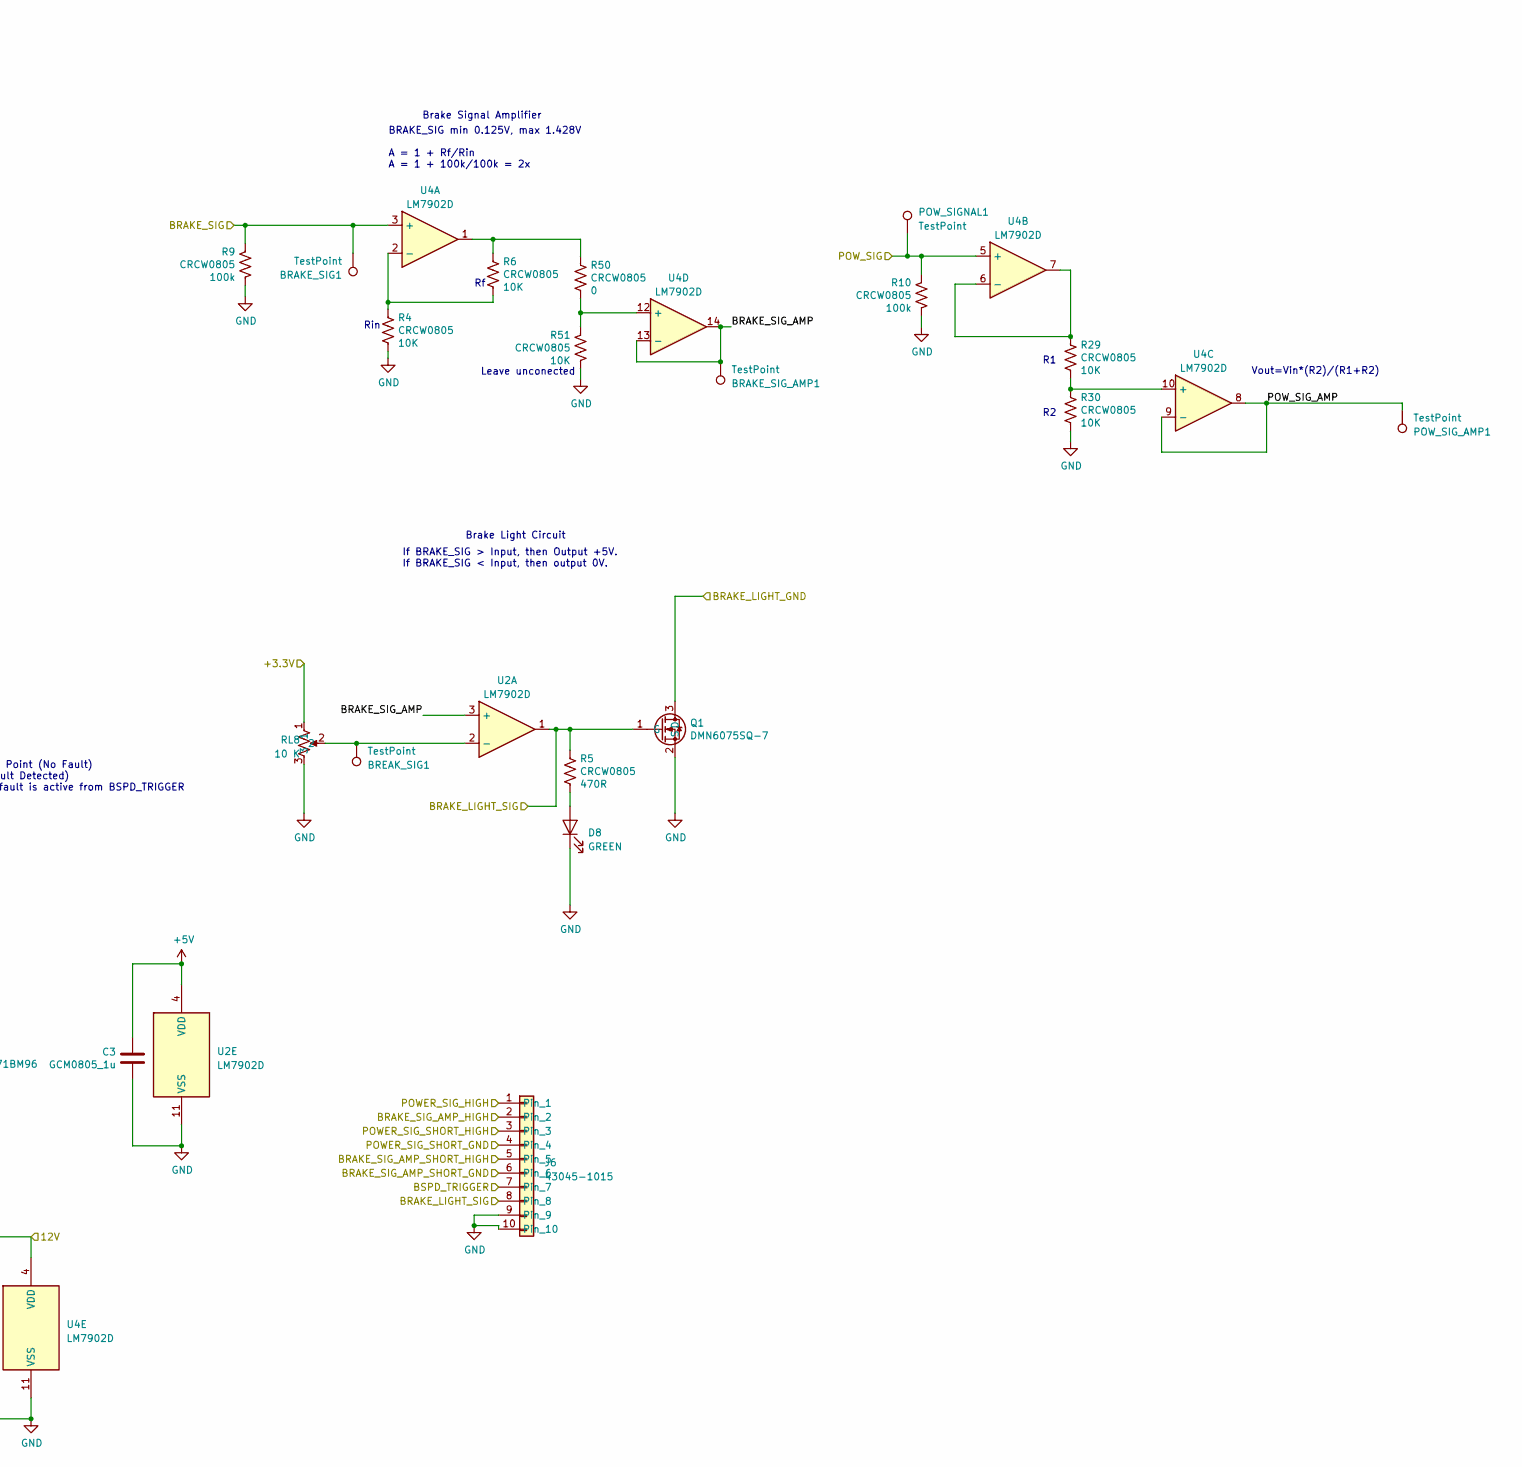
[picture p12: schematic logic.kicad_sch, part in row 1, column 2]

Parts:
BRAKE_SIG1: TestPoint; TestPoint_Pad_D2.0mm
BRAKE_SIG_AMP1: TestPoint; TestPoint_Pad_D2.0mm
BREAK_HIGH1: TestPoint; TestPoint_Pad_D2.0mm
BREAK_LOW1: TestPoint; TestPoint_Pad_D2.0mm
BREAK_PRESSED1: TestPoint; TestPoint_Pad_D2.0mm
BREAK_SIG1: TestPoint; TestPoint_Pad_D2.0mm
C2, C3, C4, C5: GCM0805_1u; 0805; Voltage Rating 50V
C7: GCM0805_2.2u; 0805; Voltage Rating 16V
D1, D2, D3, D4, D5, D6, D7: RED; 0805
D8: GREEN; 0805
J6: 43045-1015; MOLEX_43045-10YY_10PIN
POW_HIGH1: TestPoint; TestPoint_Pad_D2.0mm
POW_LOW1: TestPoint; TestPoint_Pad_D2.0mm
POW_PRESSED1: TestPoint; TestPoint_Pad_D2.0mm
POW_SIGNAL1: TestPoint; TestPoint_Pad_D2.0mm
POW_SIG_AMP1: TestPoint; TestPoint_Pad_D2.0mm
Q1: DMN6075SQ-7; SOT-23-3
R3, R4, R5, R6, R7, R9, R10, R13, R14, R15, R16, R17, R18, R19, R21, R29, R30, R50, R51: CRCW0805; 0805; Voltage Rating 150V; Power Rating 125mW
RC_TRIG1: TestPoint; TestPoint_Pad_D2.0mm
RL1, RL2, RL3, RL4, RL5, RL6, RL7, RL8: 10 K; 3296W-1
U1: 74LVC1G08GW,125; TSSOP-5
U2, U3, U4: LM7902D; SOIC-14
U7: CD4071BM96; SOIC-14

Connections:
+3V3: RL1.1, RL2.1, RL3.1, RL4.1, RL5.1, RL6.1, RL7.1, RL8.1; also elsewhere on the board
+5V: C2.1, C3.1, C4.1, U1.5 (VCC), U2.4 (VDD), U3.4 (VDD), U7.14 (VDD); also elsewhere on the board
+12V: C5.1, U4.4 (VDD); also elsewhere on the board
/Connectors/BRAKE_LIGHT_GND: Q1.3 (D); also elsewhere on the board
/Connectors/BSPD_TRIGGER: J6.7, R21.1, U3.14; also elsewhere on the board
/Connectors/ECU_BRAKE_INPUT: BRAKE_SIG1.1, R9.1, U4.3 (+); also elsewhere on the board
/Connectors/POWER_SIGNAL: POW_SIGNAL1.1, R10.1, U4.5 (+); also elsewhere on the board
/feather/BRAKE_LIGHT_SIG: J6.8, Q1.1 (G), R5.1, U2.1; also elsewhere on the board
/feather/BRAKE_SIG_AMP_HIGH: J6.2, R14.1, U1.2, U2.8; also elsewhere on the board
/feather/BRAKE_SIG_AMP_SHORT_GND: J6.6, R18.1, U3.8, U7.6; also elsewhere on the board
/feather/BRAKE_SIG_AMP_SHORT_HIGH: J6.5, R17.1, U3.7, U7.5; also elsewhere on the board
/feather/POWER_SIG_HIGH: J6.1, R13.1, U1.1, U2.7; also elsewhere on the board
/feather/POWER_SIG_SHORT_GND: J6.4, R16.1, U3.1, U7.2; also elsewhere on the board
/feather/POWER_SIG_SHORT_HIGH: J6.3, R15.1, U2.14, U7.1; also elsewhere on the board
/logic/BRAKE_SIG_AMP: BRAKE_SIG_AMP1.1, U2.3 (+), U2.10 (+), U3.5 (+), U3.9 (-), U4.13 (-), U4.14
/logic/POW_SIG_AMP: POW_SIG_AMP1.1, U2.5 (+), U2.12 (+), U3.2 (-), U4.8, U4.9 (-)
GND: C2.2, C3.2, C4.2, C5.2, C7.2, D1.1 (K), D2.1 (K), D3.1 (K), D4.1 (K), D5.1 (K), D6.1 (K), D7.1 (K), D8.1 (K), J6.9, J6.10, Q1.2 (S), R3.2, R4.2, R9.2, R10.2, R30.2, R51.2, RL1.3, RL2.3, RL3.3, RL4.3, RL5.3, RL6.3, RL7.3, RL8.3, U1.3 (GND), U2.11 (VSS), U3.11 (VSS), U4.11 (VSS), U7.7 (VSS); also elsewhere on the board
unnamed: D1.2 (A), R21.2
unnamed: D2.2 (A), R13.2
unnamed: D3.2 (A), R14.2
unnamed: D4.2 (A), R15.2
unnamed: D5.2 (A), R16.2
unnamed: D6.2 (A), R17.2
unnamed: D7.2 (A), R18.2
unnamed: D8.2 (A), R5.2
unnamed: R7.1, U7.11
unnamed: R3.1, R7.2, R19.1
unnamed: R6.1, R50.1, U4.1
unnamed: U1.4, U7.12
unnamed: BREAK_SIG1.1, RL8.2, U2.2 (-)
unnamed: POW_PRESSED1.1, RL1.2, U2.6 (-)
unnamed: BREAK_PRESSED1.1, RL2.2, U2.9 (-)
unnamed: POW_HIGH1.1, RL3.2, U2.13 (-)
unnamed: POW_LOW1.1, RL4.2, U3.3 (+)
unnamed: BREAK_HIGH1.1, RL5.2, U3.6 (-)
unnamed: BREAK_LOW1.1, RL6.2, U3.10 (+)
unnamed: RC_TRIG1.1, RL7.2, U3.12 (+)
unnamed: C7.1, R19.2, U3.13 (-)
unnamed: R4.1, R6.2, U4.2 (-)
unnamed: R29.1, U4.6 (-), U4.7
unnamed: R29.2, R30.1, U4.10 (+)
unnamed: R50.2, R51.1, U4.12 (+)
unnamed: U7.3, U7.8
unnamed: U7.4, U7.9
unnamed: U7.10, U7.13

Notes on the sheet:
If BRAKE_SIG > Input, then Output +5V. If BRAKE_SIG < Input, then output 0V.
POWER_SIG short to high check If POWER_SIG > Input (should be about 4.5V) , then output high
Leave unconected
POWER_SIG short to ground check If POWER_SIG < Input (should be about 0.5V) , then output high
RC circuit time constant is 0.5 seconds. Hence voltage should reach approx 3 volts in 0.5s.
Brake System Plausibility Device Logic If POWER_SIG > 5KW and BRAKE_SIG > "Hard pressed"
Brake Light Circuit
Vout=Vin*(R2)/(R1+R2)
BRAKE_SIG short to ground check If BRAKE_SIG < Input (should be about 0.5V) , then output high
Rin
BRAKE_SIG short to high check If BRAKE_SIG > Input (should be about 4.5V) , then output high
Fine adjustement of RC trigger point
Brake Signal Amplifier
BRAKE_SIG min 0.125V, max 1.428V A = 1 + Rf/Rin A = 1 + 100k/100k = 2x
BSPD_TRIGGER is high when input < RC Trigger Point (No Fault) and low when input > RC Trigger Point (Fault Detected) This circuit cannot determine what sort of fault is active from BSPD_TRIGGER

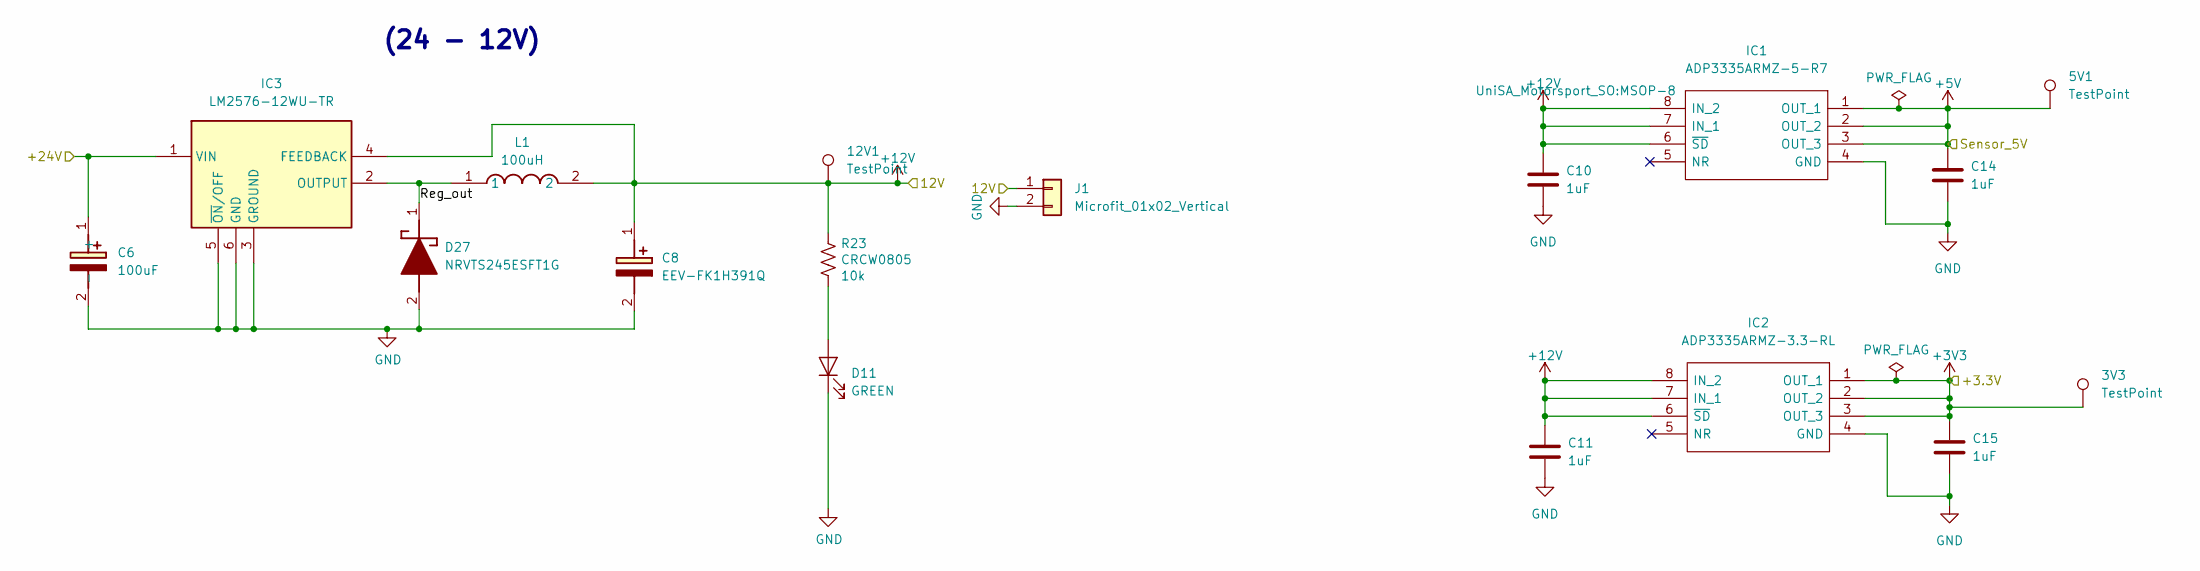
[picture p13: schematic voltage_reg.kicad_sch]

Parts:
3V3, 5V1, 12V1: TestPoint; TestPoint_Pad_D2.0mm
C6: 100uF; EEEFK0J332AQ
C8: EEV-FK1H391Q; EEEFK0J332AQ; Mouser Part Number 667-EEV-FK1H391Q
C10, C11, C14, C15: 1uF; C_0805_2012Metric
D11: GREEN; 0805
D27: NRVTS245ESFT1G; SOD-123FL-2; Mouser Part Number 863-NRVTS245ESFT1G
IC1: ADP3335ARMZ-5-R7; MSOP-8; Mouser Part Number 584-ADP3335ARMZ-5-R7
IC2: ADP3335ARMZ-3.3-RL; MSOP-8; Mouser Part Number 584-ADP3335ARMZ3.3R
IC3: LM2576-12WU-TR; TO-263-5; Mouser Part Number 998-LM2576-12WUTR
J1: Microfit_01x02_Vertical; Molex_Micro-Fit_43650-0215_1x02_Vertical
L1: 100uH; 5050
R23: CRCW0805; 0805; Voltage Rating 50V; Power Rating 63mW

Connections:
+3V3: 3V3.1, C15.1, IC2.1 (OUT_1), IC2.2 (OUT_2), IC2.3 (OUT_3); also elsewhere on the board
+5V: 5V1.1, C14.1, IC1.1 (OUT_1), IC1.2 (OUT_2), IC1.3 (OUT_3); also elsewhere on the board
+12V: 12V1.1, C8.1 (+), C10.1, C11.1, IC1.6 (~SD), IC1.7 (IN_1), IC1.8 (IN_2), IC2.6 (~SD), IC2.7 (IN_1), IC2.8 (IN_2), IC3.4 (FEEDBACK), J1.1, L1.2, R23.1; also elsewhere on the board
+24V: C6.1 (+), IC3.1 (VIN); also elsewhere on the board
/voltage_reg/Reg_out: D27.1 (K), IC3.2 (OUTPUT), L1.1
GND: C6.2 (-), C8.2 (-), C10.2, C11.2, C14.2, C15.2, D11.1 (K), D27.2 (A), IC1.4 (GND), IC2.4 (GND), IC3.3 (GROUND), IC3.5 (~ON/OFF), IC3.6 (GND), J1.2; also elsewhere on the board
unnamed: D11.2 (A), R23.2

Notes on the sheet:
(24 - 12V)
