UniSA-Motorsport-Test1/2024-power-and-monitoring-board/power_and_monotoring/power_and_monotoring.kicad_pcb

## KiCad design power_and_monotoring/power_and_monotoring.kicad_pcb (continued)

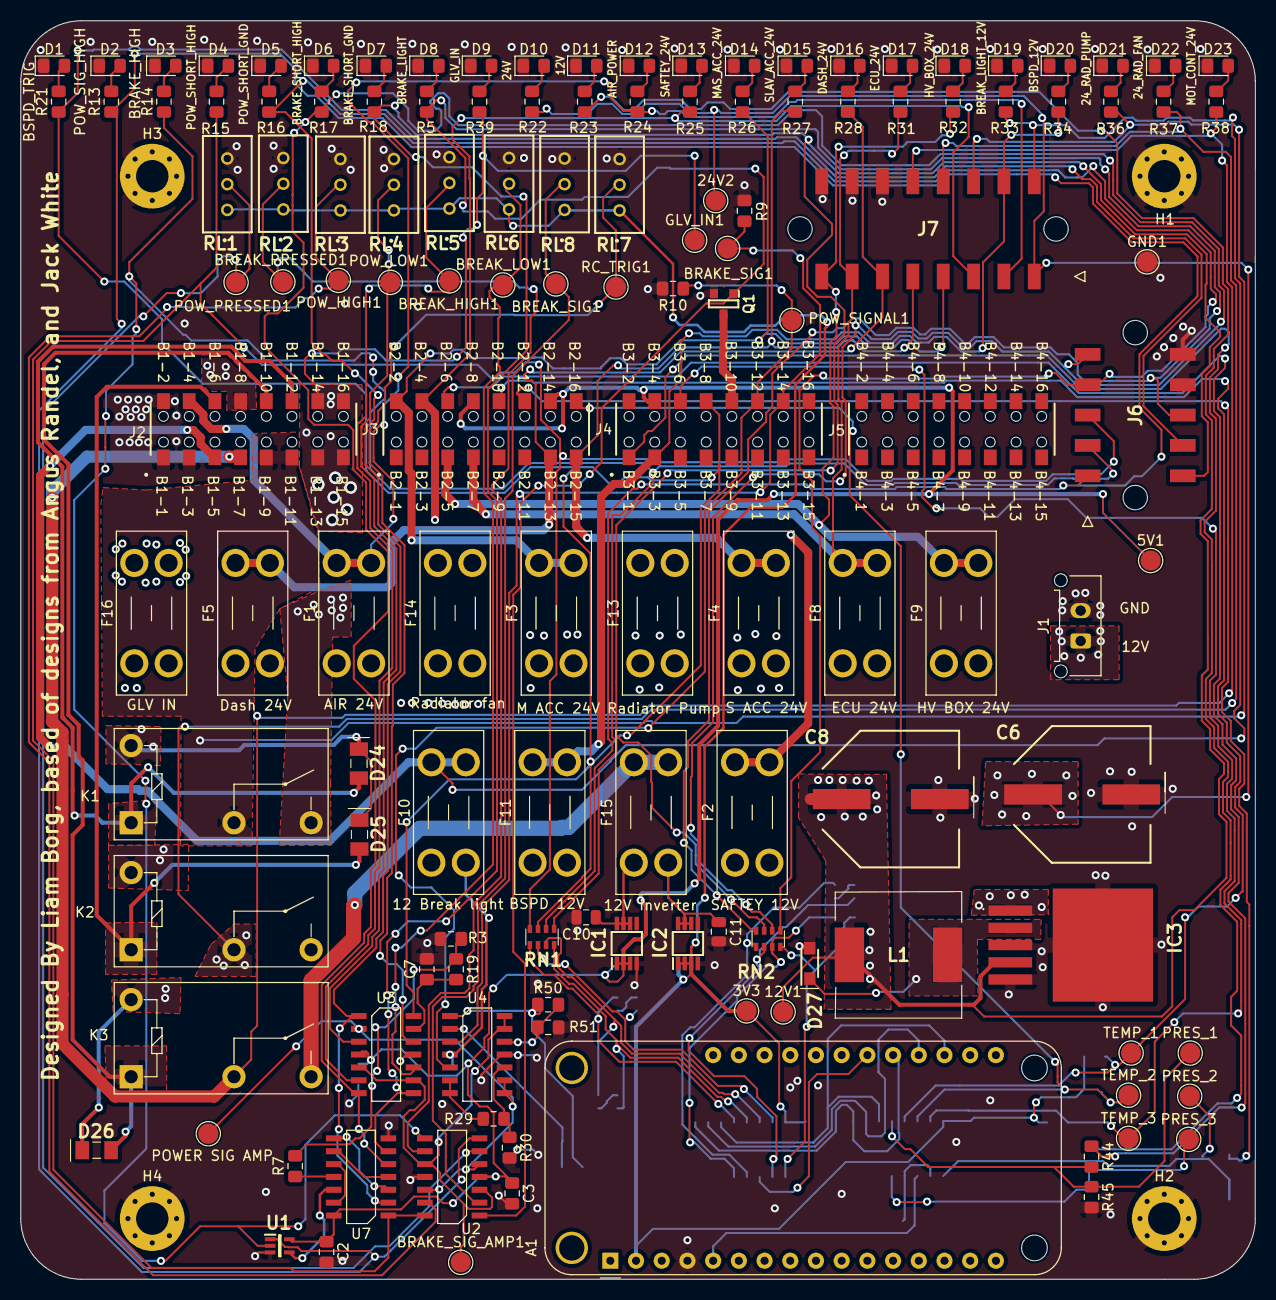
[picture p14: board power_and_monotoring.kicad_pcb from above]

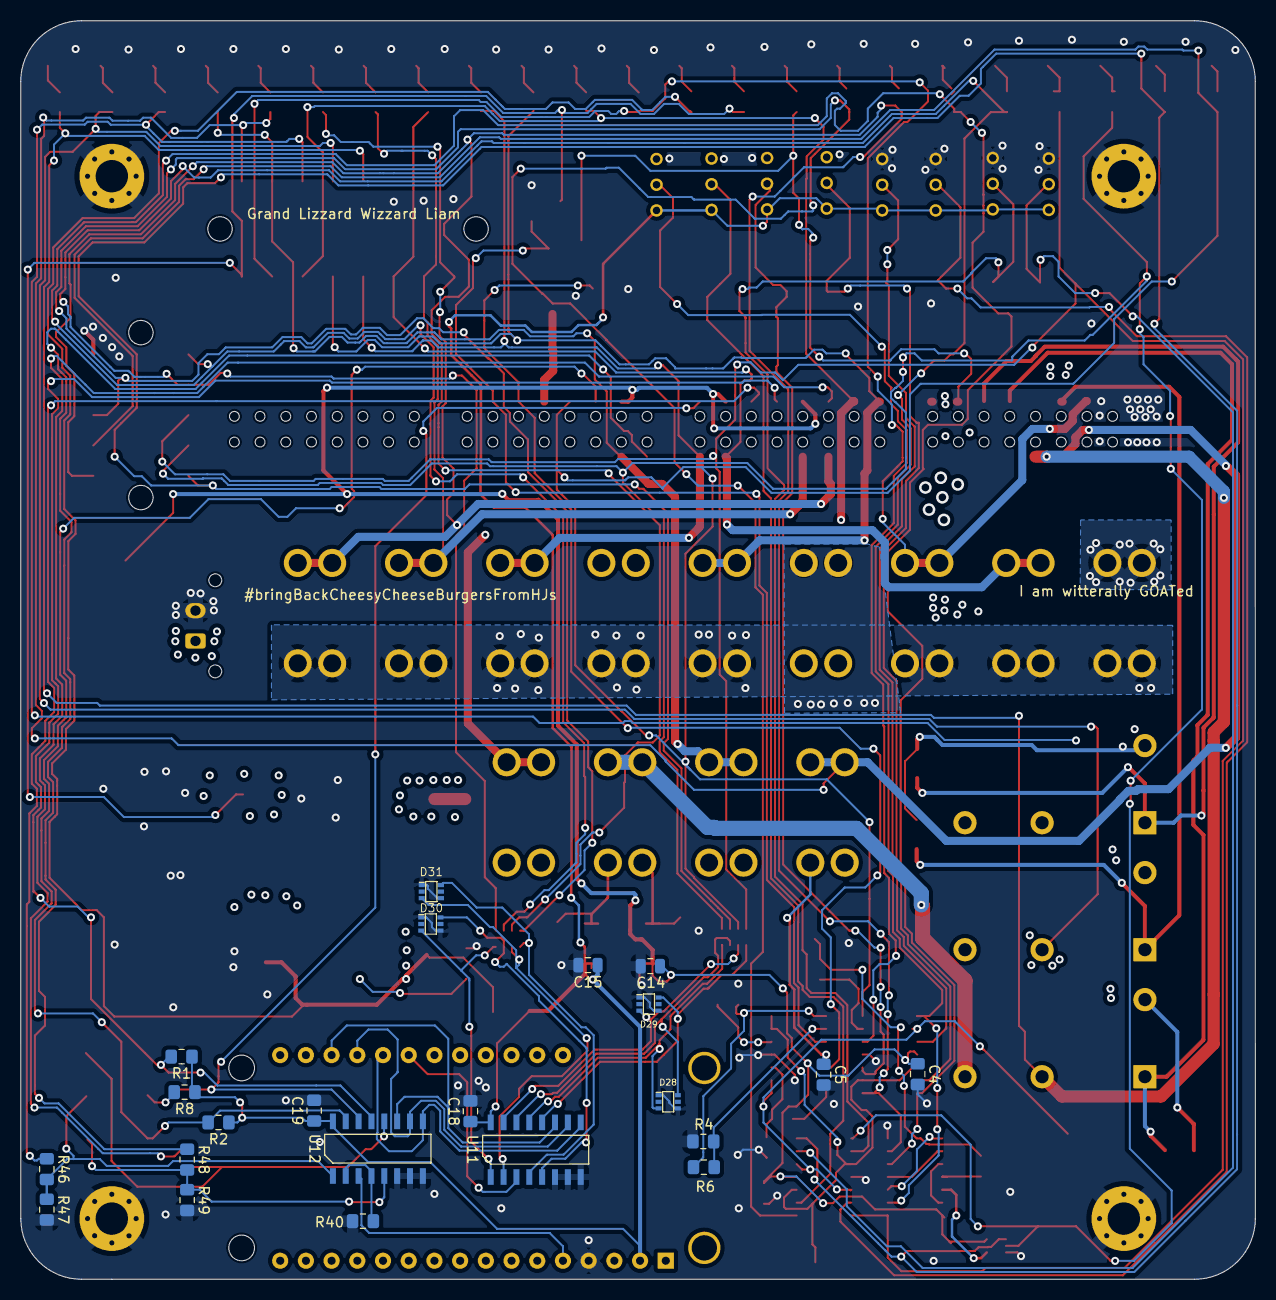
[picture p15: board power_and_monotoring.kicad_pcb from below]

Board: 4 copper layers, 122.0 x 124.4 mm, 162 parts (22 on the bottom side), 104 nets.

Other parts of the board:
H1, H2, H3, H4: MountingHole_Pad; MountingHole_3.2mm_M3_Pad_Via

Their connections:
GND: H1.1, H2.1, H3.1, H4.1; also elsewhere on the board
