UniSA-Motorsport-Test1/2024-power-and-monitoring-board/(commit log)

2024-03-10 Finished shematic and initial layout (NO CONNECTIONS))
    [Connectors.kicad_sch, feather.kicad_sch, fuses.kicad_sch, logic.kicad_sch, power_and_monotoring.kicad_pcb, power_and_monotoring.kicad_sch, voltage_reg.kicad_sch]
2024-03-19 first connections done (not perfect yet)
    [Connectors.kicad_sch, fuses.kicad_sch, logic.kicad_sch, power_and_monotoring.kicad_pcb]
2024-04-23 before design review
    [fuses.kicad_sch, logic.kicad_sch, power_and_monotoring.kicad_pcb, voltage_reg.kicad_sch]
2024-09-12 Updated 12 Sep
    [power_and_monotoring.kicad_pcb]
2024-10-16 Made it 4 layers
    [BOM_CHECKLIST.xlsx, Connectors.kicad_sch, NEW_BOM.csv, fuses.kicad_sch, logic.kicad_sch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]
